sshersh/SuperAudioBoard/KiCADFiles/Mic_Preamp_Sim_Project/averaged_cycle.png

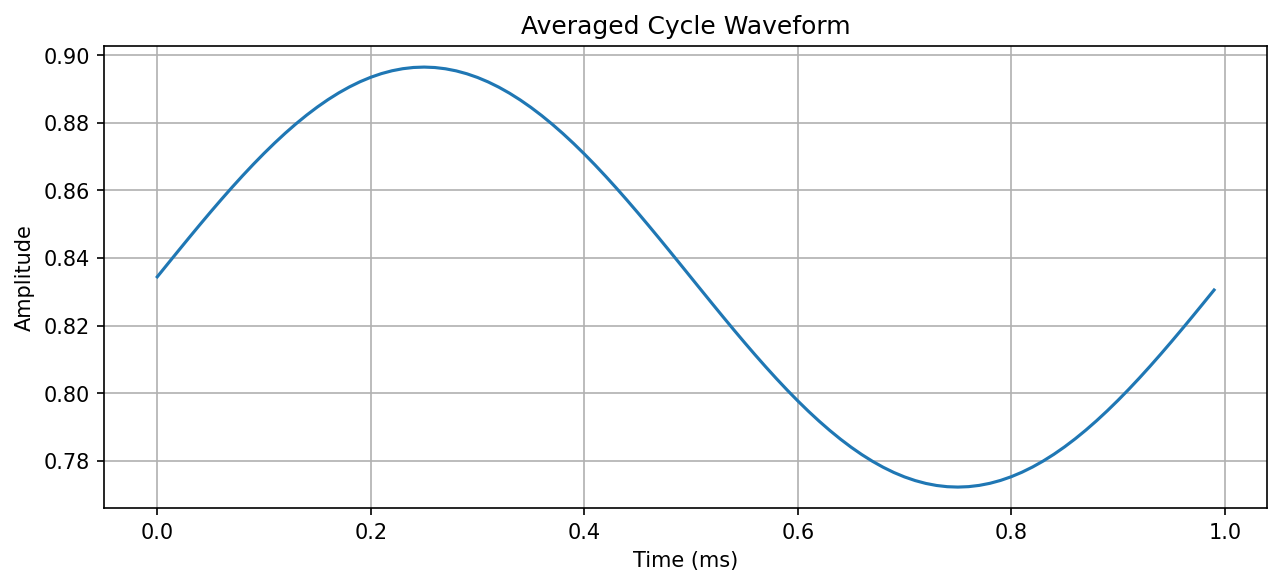
KiCADFiles/Mic_Preamp_Sim_Project/averaged_cycle.png
