sshersh/SuperAudioBoard/KiCADFiles/Mic_Preamp_Sim_Project/bfma_configuration_default_spectrum.png

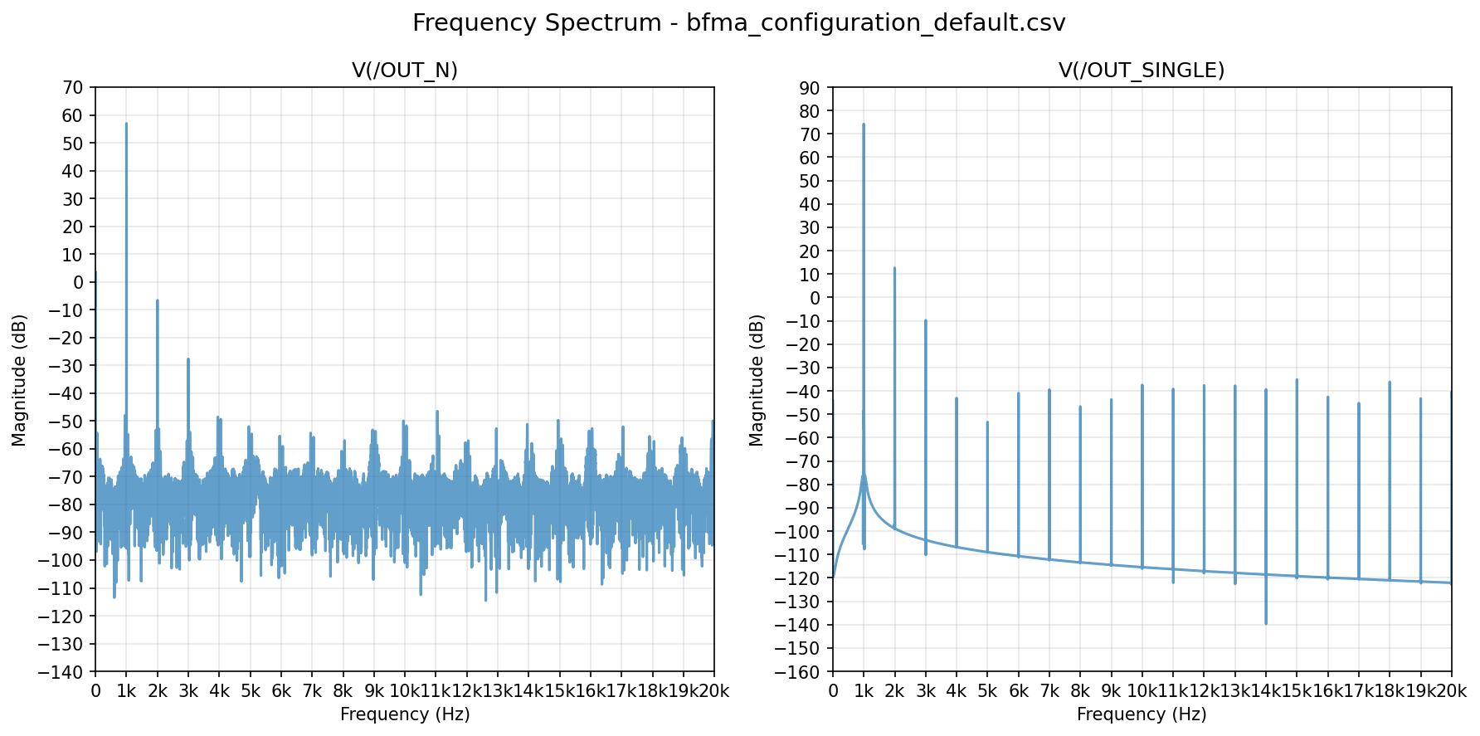
KiCADFiles/Mic_Preamp_Sim_Project/bfma_configuration_default_spectrum.png
