sshersh/SuperAudioBoard/KiCADFiles/Mic_Preamp_Sim_Project/collector_resistors_3k_spectrum.png

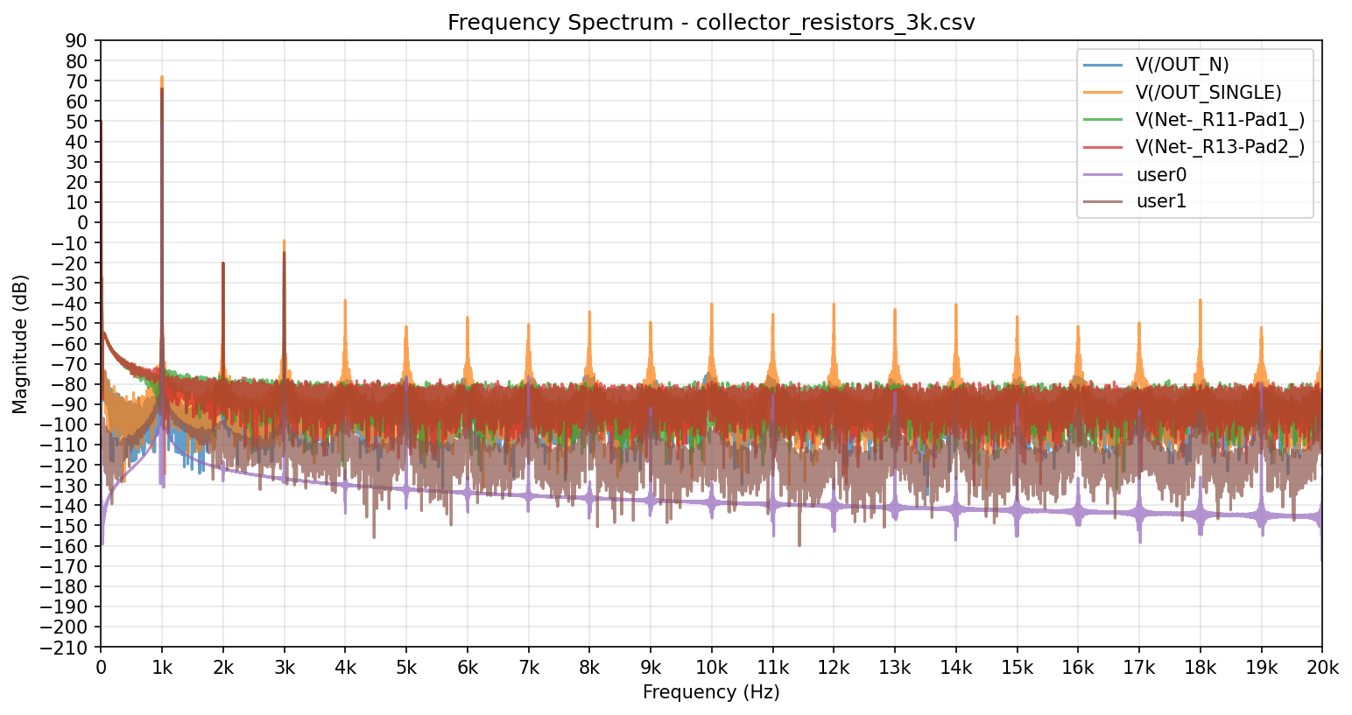
KiCADFiles/Mic_Preamp_Sim_Project/collector_resistors_3k_spectrum.png
