sshersh/SuperAudioBoard/KiCADFiles/Mic_Preamp_Sim_Project/diode_biased_first_stage_spectrum.png

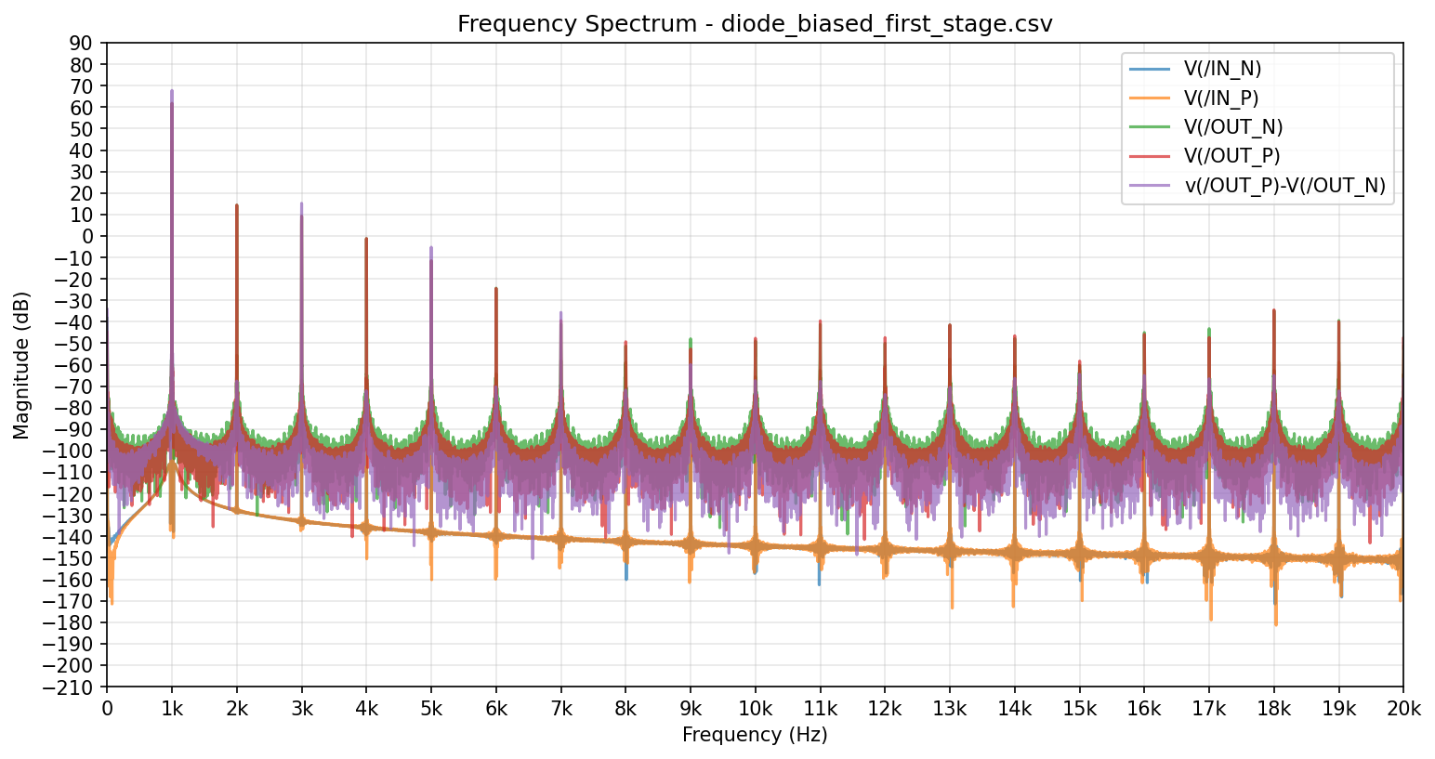
KiCADFiles/Mic_Preamp_Sim_Project/diode_biased_first_stage_spectrum.png
