sshersh/SuperAudioBoard/KiCADFiles/Mic_Preamp_Sim_Project/full_two_stages_10k_fb_res_spectrum.png

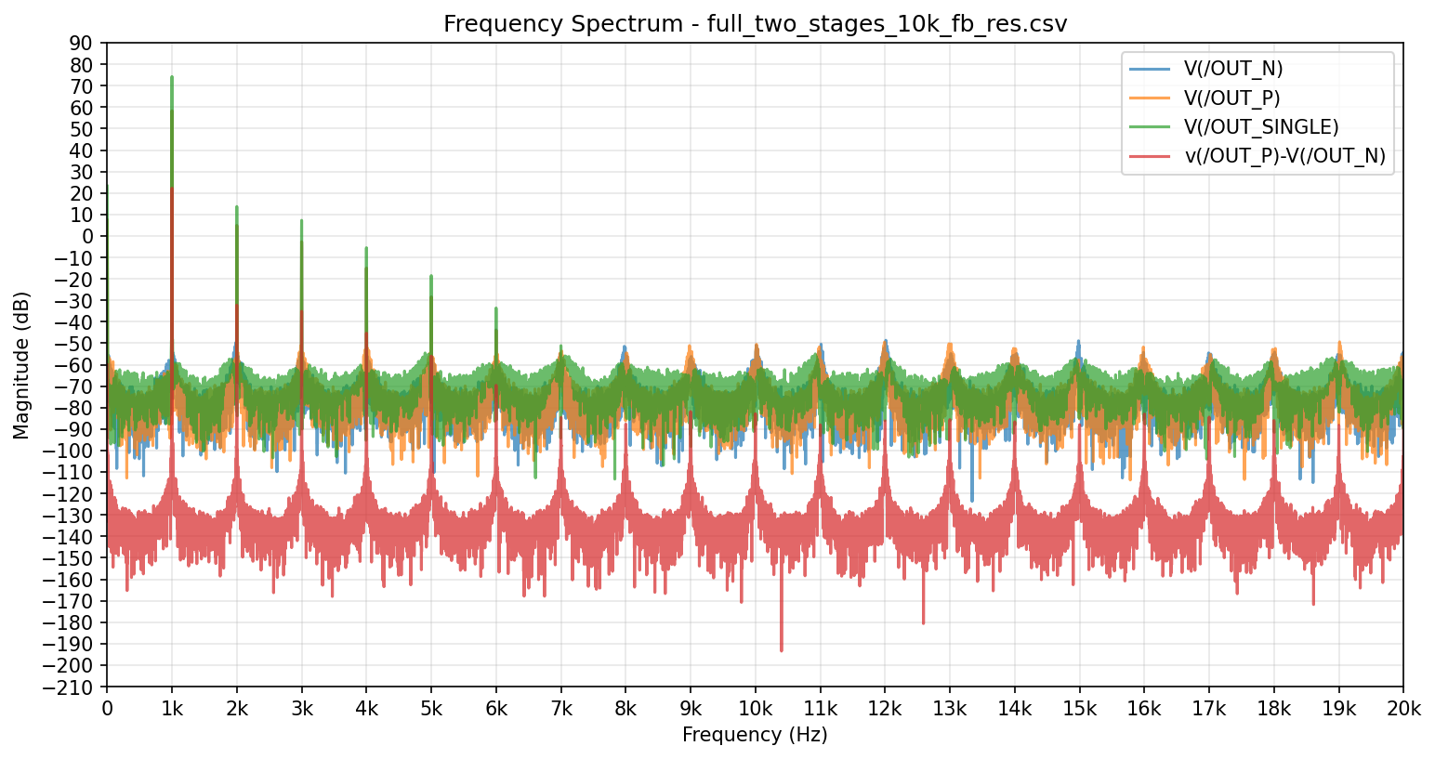
KiCADFiles/Mic_Preamp_Sim_Project/full_two_stages_10k_fb_res_spectrum.png
