sshersh/SuperAudioBoard/KiCADFiles/Mic_Preamp_Sim_Project/highest_gain_setting_22k_fb_spectrum.png

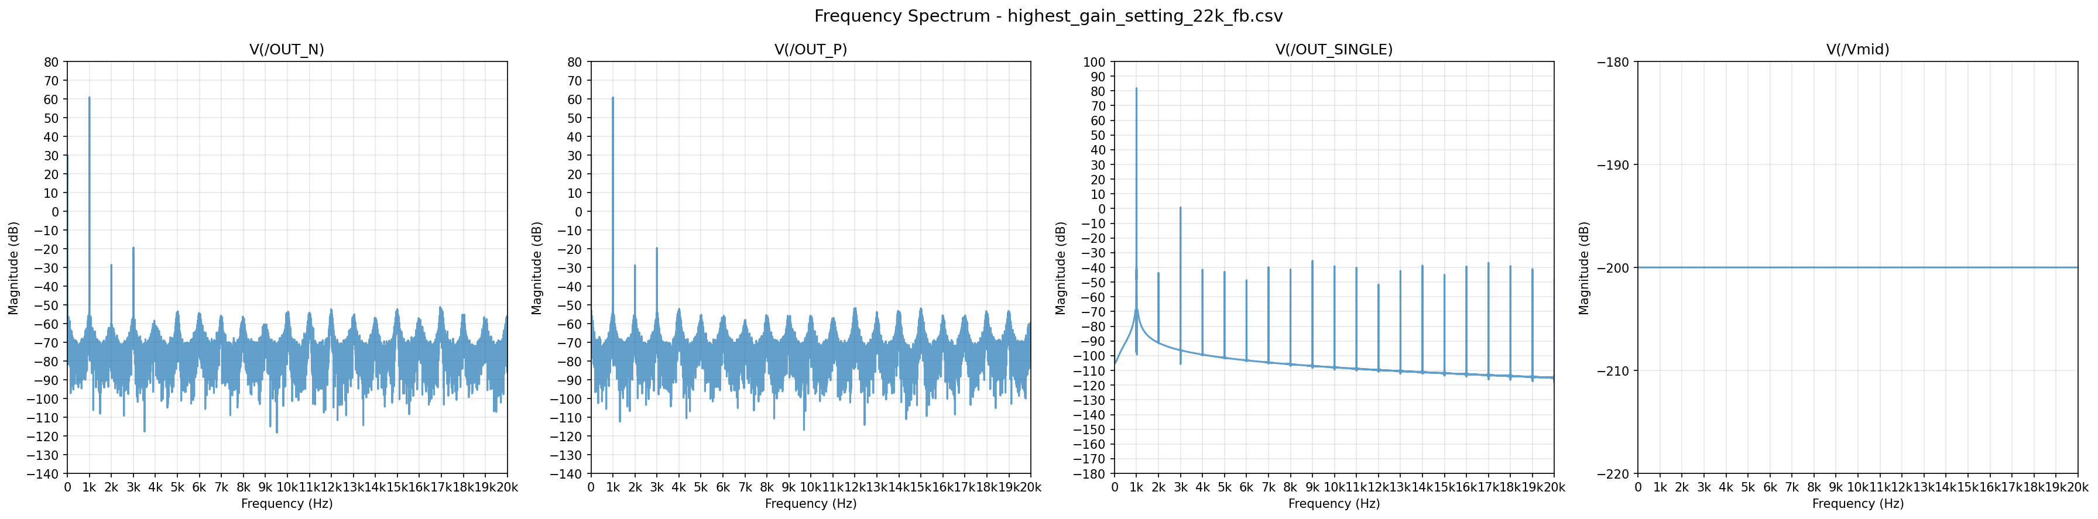
KiCADFiles/Mic_Preamp_Sim_Project/highest_gain_setting_22k_fb_spectrum.png
