sshersh/SuperAudioBoard/KiCADFiles/Mic_Preamp_Sim_Project/instr_amp_full_sim_1s_spectrum.png

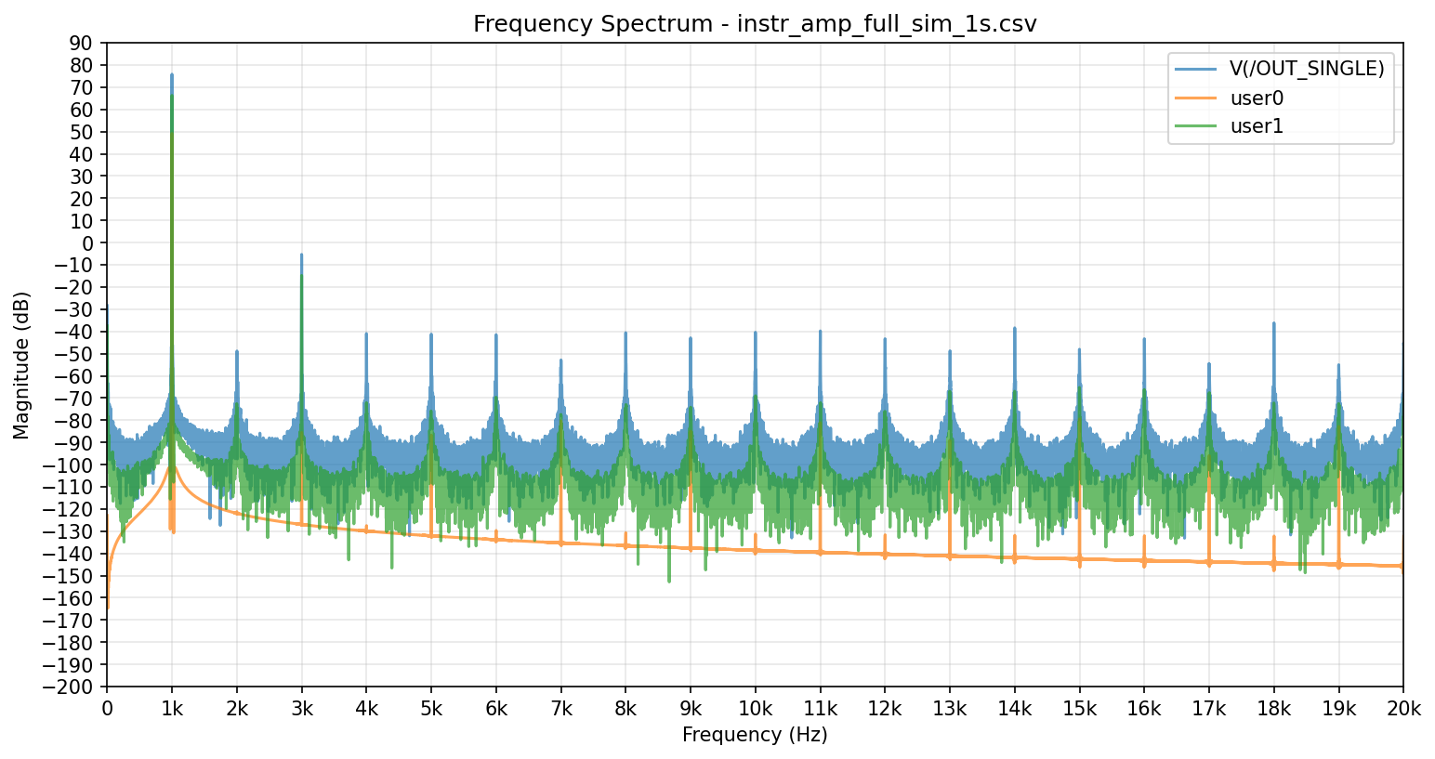
KiCADFiles/Mic_Preamp_Sim_Project/instr_amp_full_sim_1s_spectrum.png
