sshersh/SuperAudioBoard/KiCADFiles/Mic_Preamp_Sim_Project/linearity_capacitor_load_10u_spectrum.png

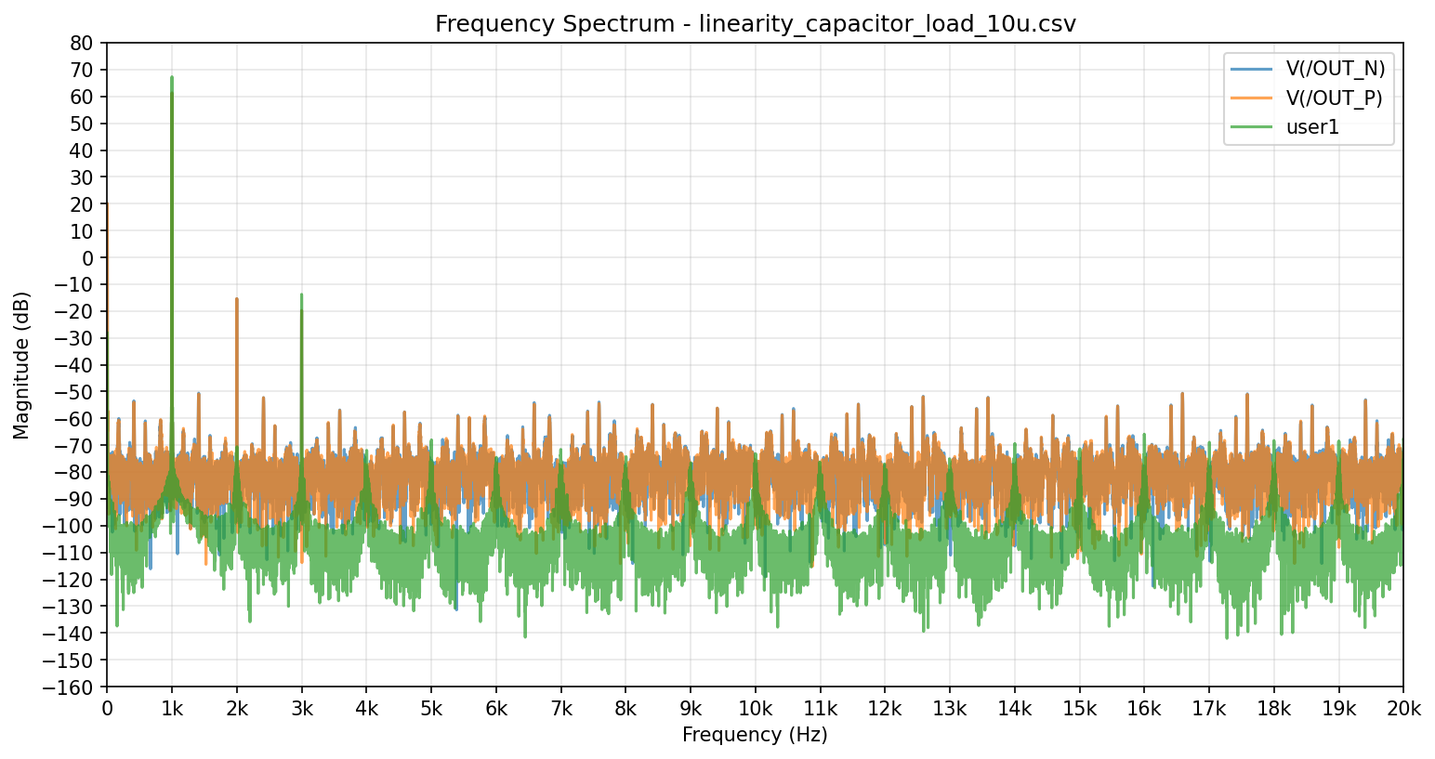
KiCADFiles/Mic_Preamp_Sim_Project/linearity_capacitor_load_10u_spectrum.png
