sshersh/SuperAudioBoard/KiCADFiles/Mic_Preamp_Sim_Project/linearity_loaded_spectrum.png

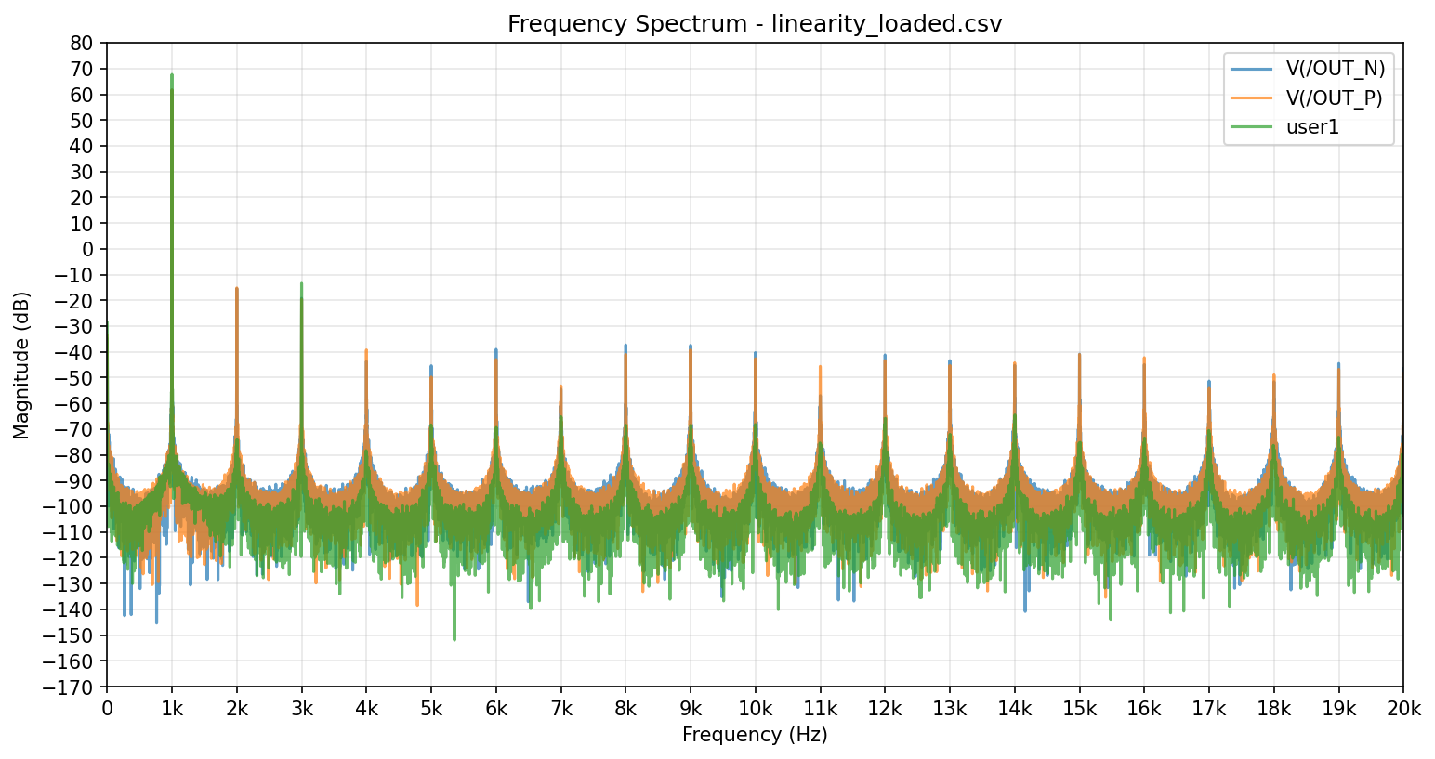
KiCADFiles/Mic_Preamp_Sim_Project/linearity_loaded_spectrum.png
