sshersh/SuperAudioBoard/KiCADFiles/Mic_Preamp_Sim_Project/pmos_instead_spectrum.png

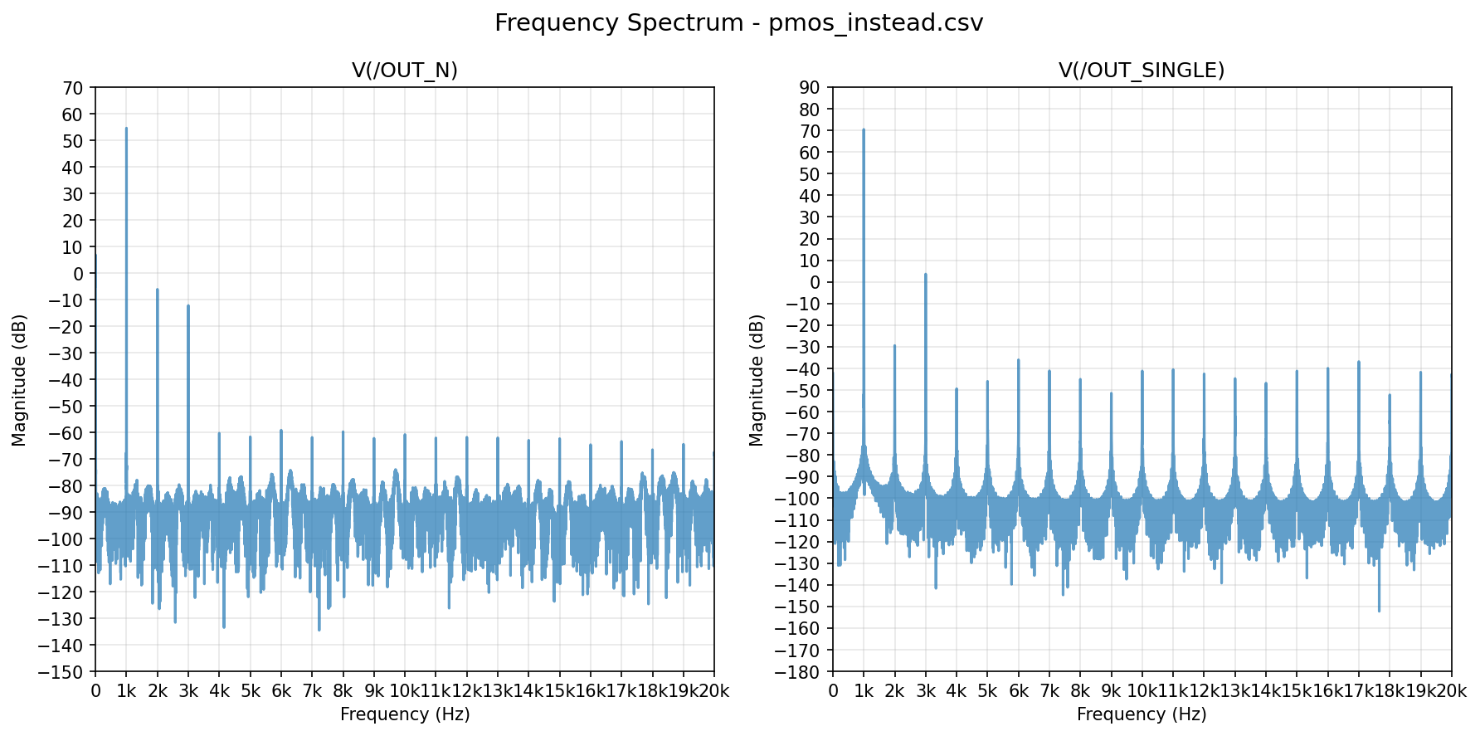
KiCADFiles/Mic_Preamp_Sim_Project/pmos_instead_spectrum.png
