sshersh/SuperAudioBoard/KiCADFiles/Mic_Preamp_Sim_Project/single_op_amp_10k_feedback_10vsupply_spectrum.png

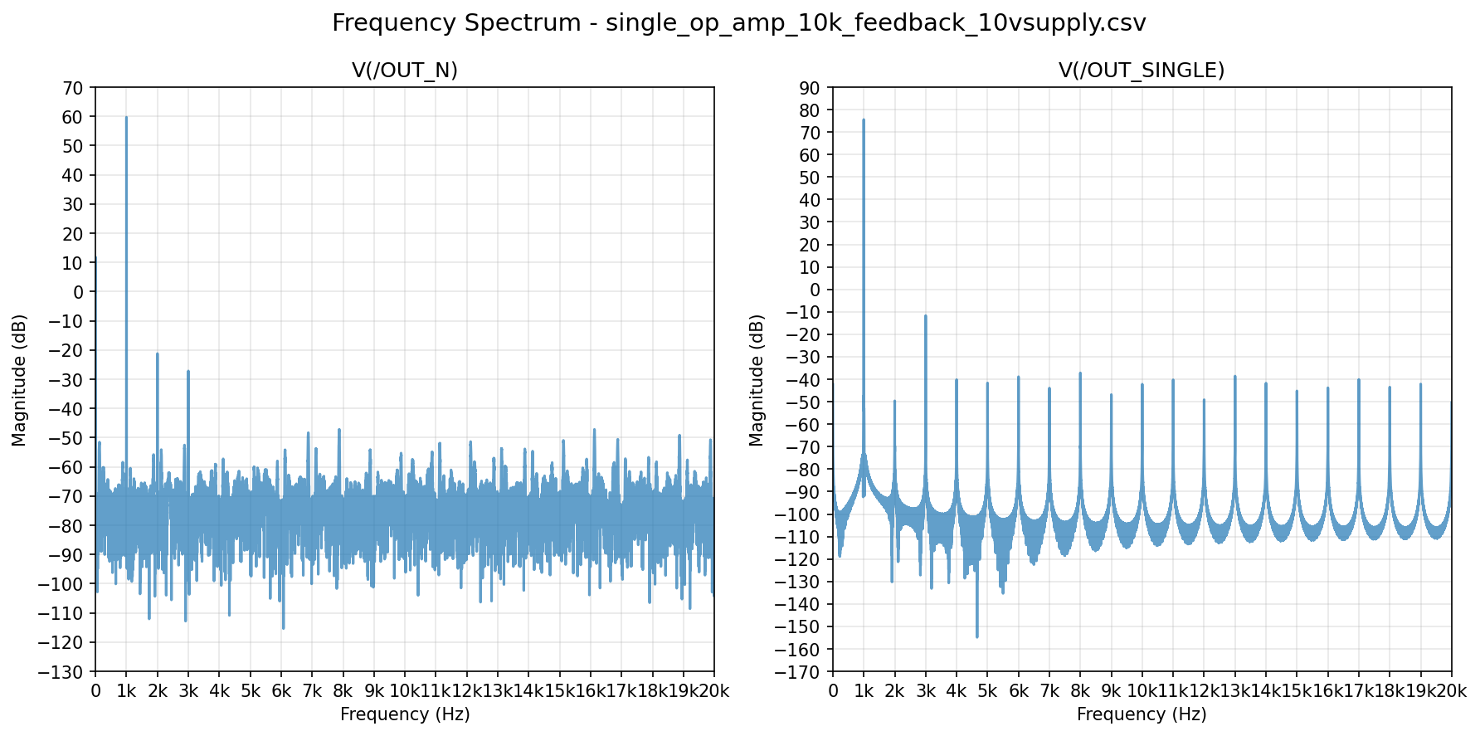
KiCADFiles/Mic_Preamp_Sim_Project/single_op_amp_10k_feedback_10vsupply_spectrum.png
