sshersh/SuperAudioBoard/KiCADFiles/Mic_Preamp_Sim_Project/single_op_amp_22k_feedback_spectrum.png

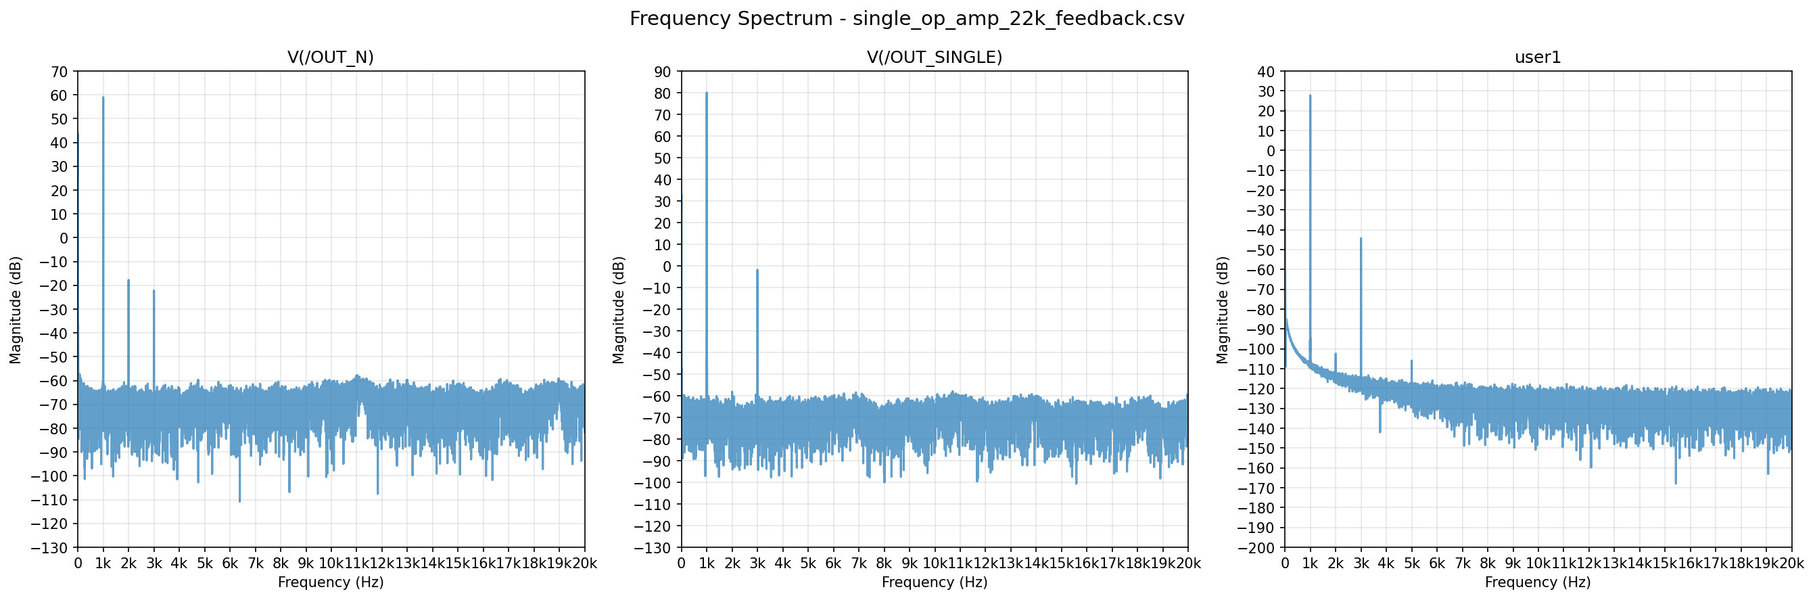
KiCADFiles/Mic_Preamp_Sim_Project/single_op_amp_22k_feedback_spectrum.png
