sshersh/SuperAudioBoard/KiCADFiles/Mic_Preamp_Sim_Project/with_30v_supply_spectrum.png

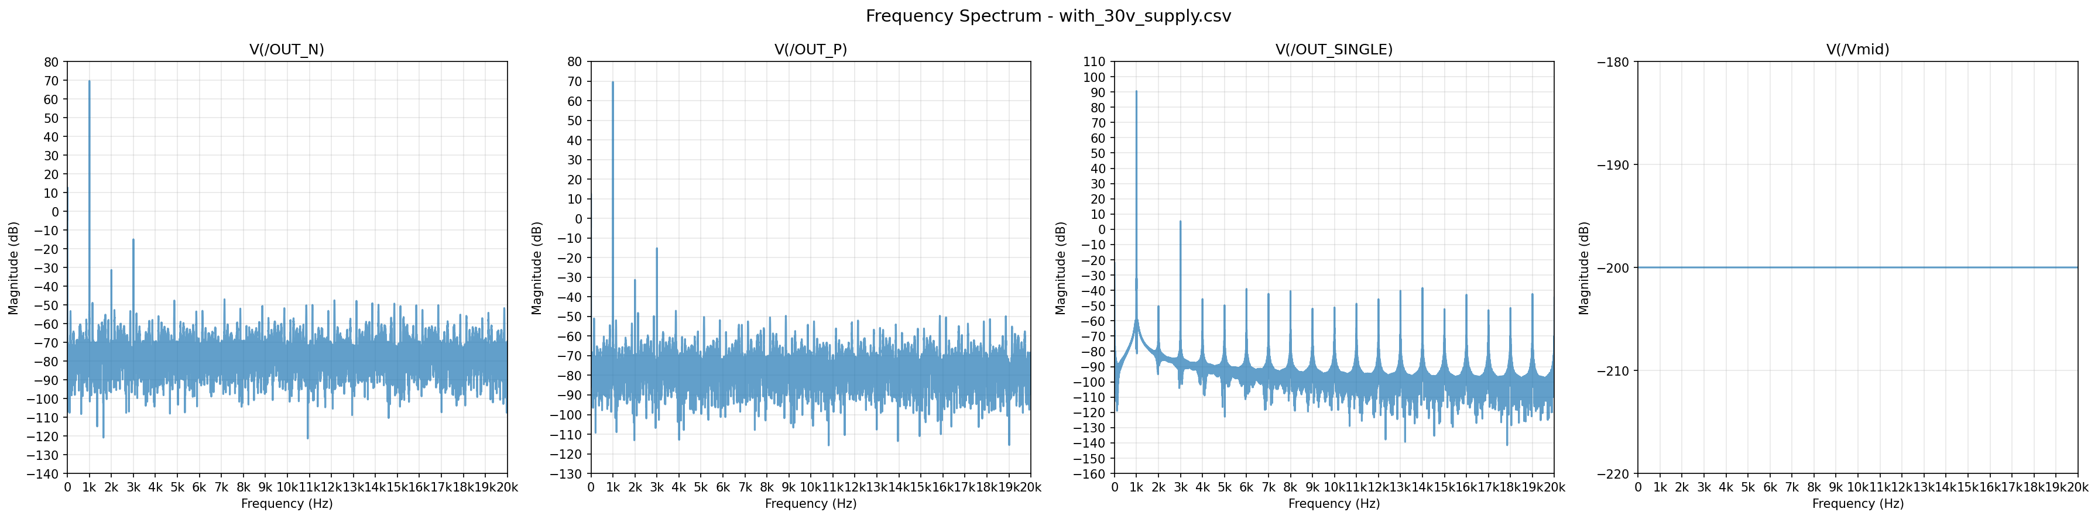
KiCADFiles/Mic_Preamp_Sim_Project/with_30v_supply_spectrum.png
