sshersh/SuperAudioBoard/KiCADFiles/Mic_Preamp_Sim_Project/with_current_source_load_spectrum.png

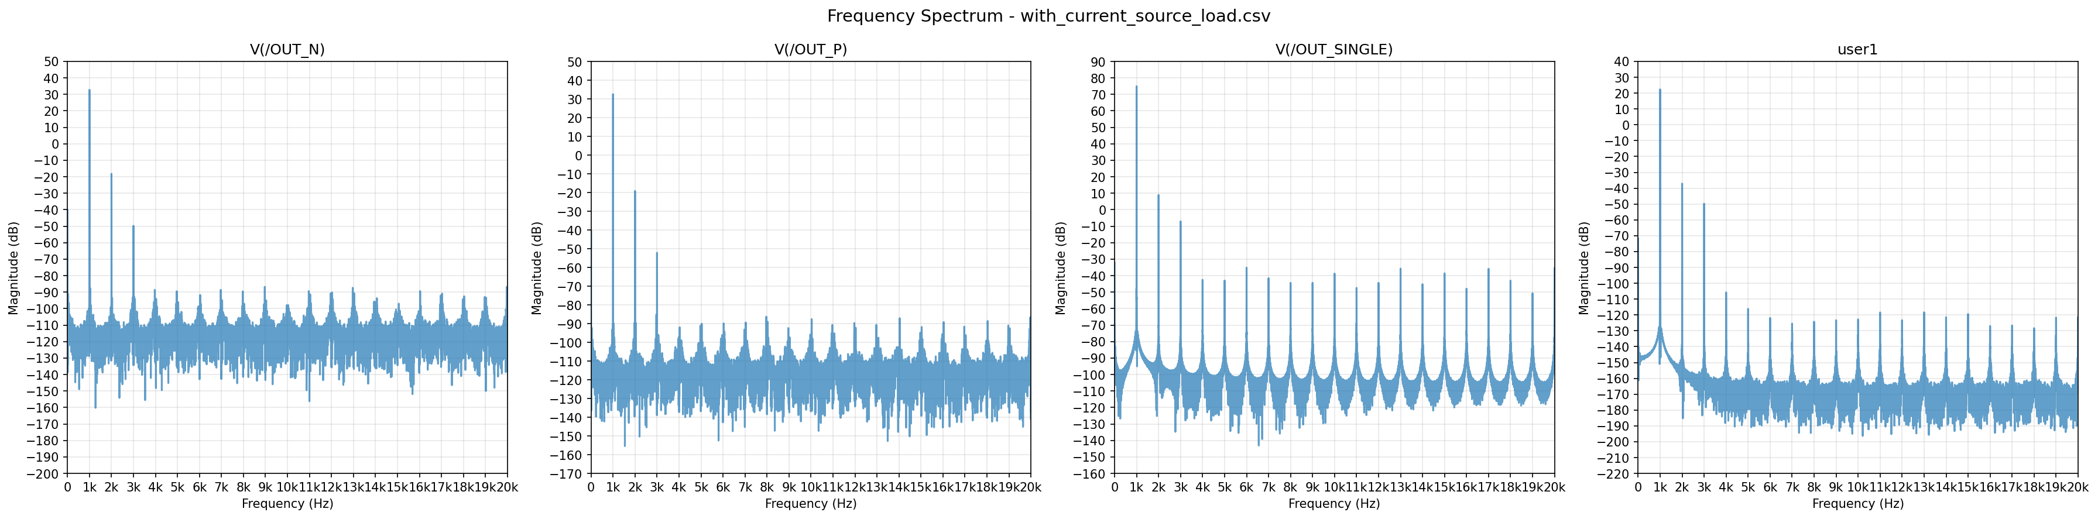
KiCADFiles/Mic_Preamp_Sim_Project/with_current_source_load_spectrum.png
