sshersh/SuperAudioBoard/KiCADFiles/Mic_Preamp_Sim_Project/with_opa1655_spectrum.png

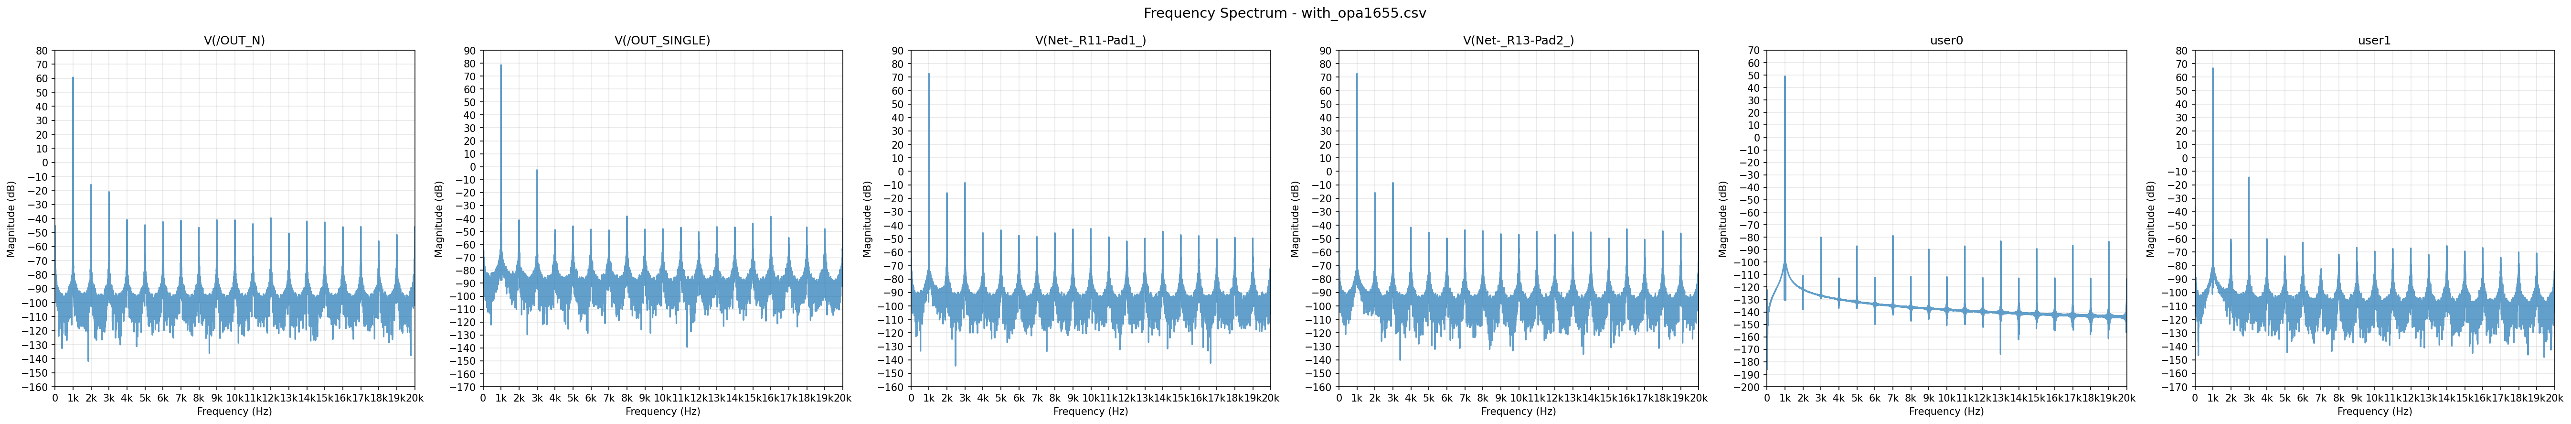
KiCADFiles/Mic_Preamp_Sim_Project/with_opa1655_spectrum.png
