sshersh/SuperAudioBoard/KiCADFiles/Mic_Preamp_Sim_Project/with_protection_diodes_spectrum.png

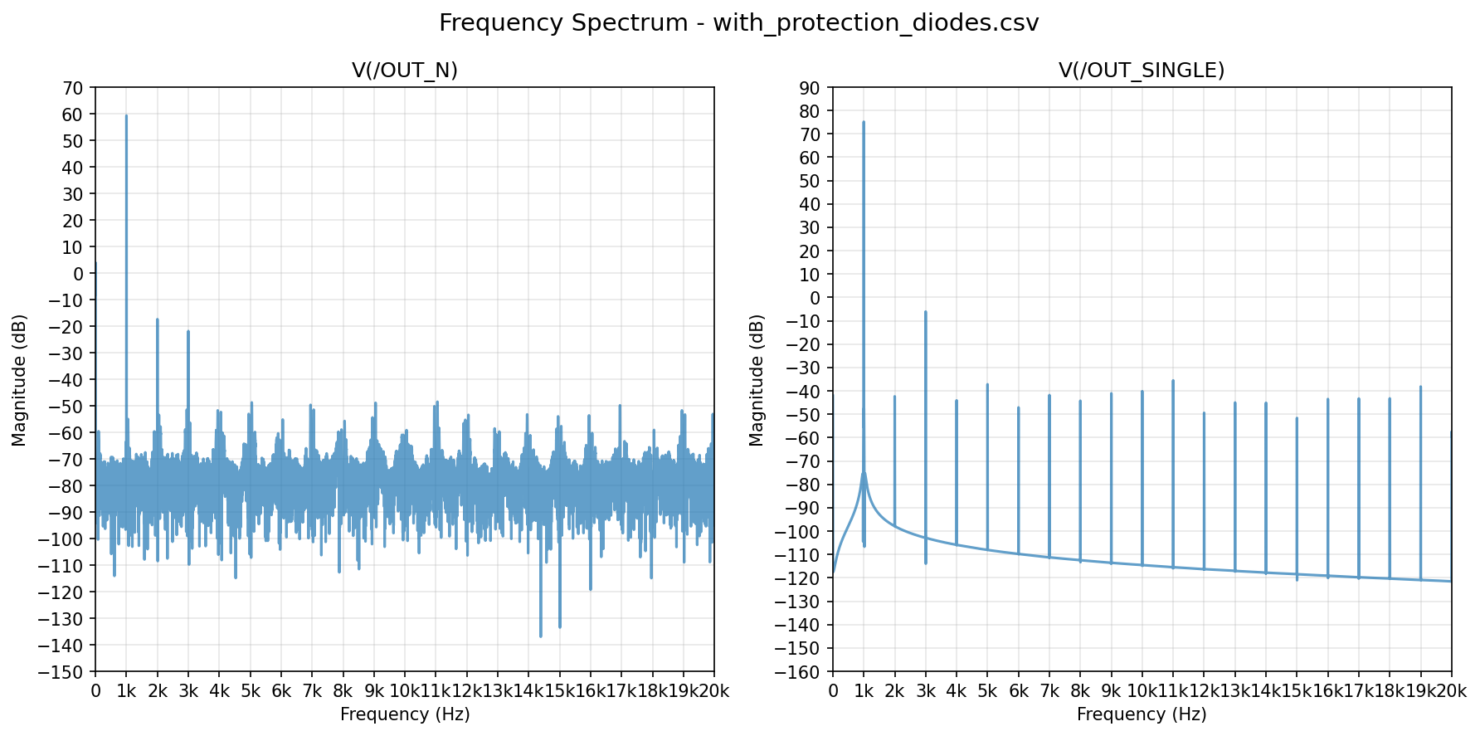
KiCADFiles/Mic_Preamp_Sim_Project/with_protection_diodes_spectrum.png
