sshersh/SuperAudioBoard/KiCADFiles/Mic_Preamp_Sim_Project/without_instr_input_network_spectrum.png

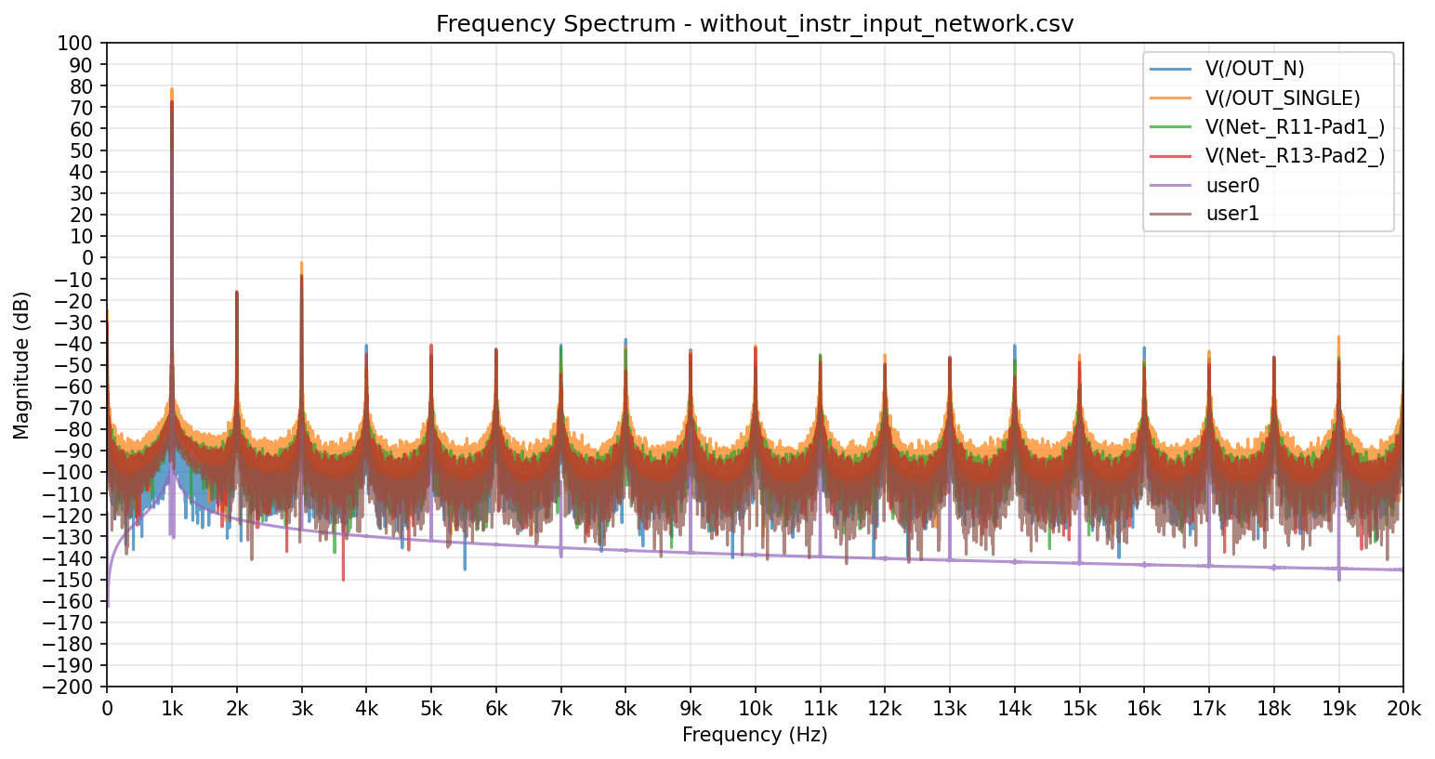
KiCADFiles/Mic_Preamp_Sim_Project/without_instr_input_network_spectrum.png
