sshersh/SuperAudioBoard/KiCADFiles/Mic_Preamp_Sim_Project/test_midpoint_again.csv

time | user0 | user1
0.100001 | 0.000149784 | -0.00112278
0.100011 | 0.00140723 | -0.00928184
0.100021 | 0.00265913 | -0.017404
0.100031 | 0.00390053 | -0.025457
0.100041 | 0.00512654 | -0.0334089
0.100051 | 0.00633232 | -0.0412279
0.100061 | 0.0075131 | -0.0488832
0.100071 | 0.00866424 | -0.0563443
0.100081 | 0.00978118 | -0.0635817
0.100091 | 0.0108595 | -0.0705669
0.100101 | 0.011895 | -0.0772723
0.100111 | 0.0128835 | -0.0836714
0.100121 | 0.0138212 | -0.0897391
0.100131 | 0.0147044 | -0.0954517
0.100141 | 0.0155295 | -0.100787
0.100151 | 0.0162933 | -0.105724
0.100161 | 0.0169928 | -0.110243
0.100171 | 0.0176253 | -0.114327
0.100181 | 0.0181882 | -0.11796
0.100191 | 0.0186793 | -0.121128
0.100201 | 0.0190967 | -0.123818
0.100211 | 0.0194388 | -0.126021
0.100221 | 0.0197041 | -0.127728
0.100231 | 0.0198916 | -0.128931
0.100241 | 0.0200007 | -0.129628
0.100251 | 0.0200308 | -0.129814
0.100261 | 0.0199819 | -0.129489
0.100271 | 0.0198541 | -0.128655
0.100281 | 0.0196479 | -0.127315
0.100291 | 0.0193643 | -0.125473
0.100301 | 0.0190041 | -0.123137
0.100311 | 0.018569 | -0.120316
0.100321 | 0.0180606 | -0.117021
0.100331 | 0.017481 | -0.113264
0.100341 | 0.0168323 | -0.10906
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
