sshersh/SuperAudioBoard/KiCADFiles/Mic_Preamp_Sim_Project/test_1v_base_spectrum.png

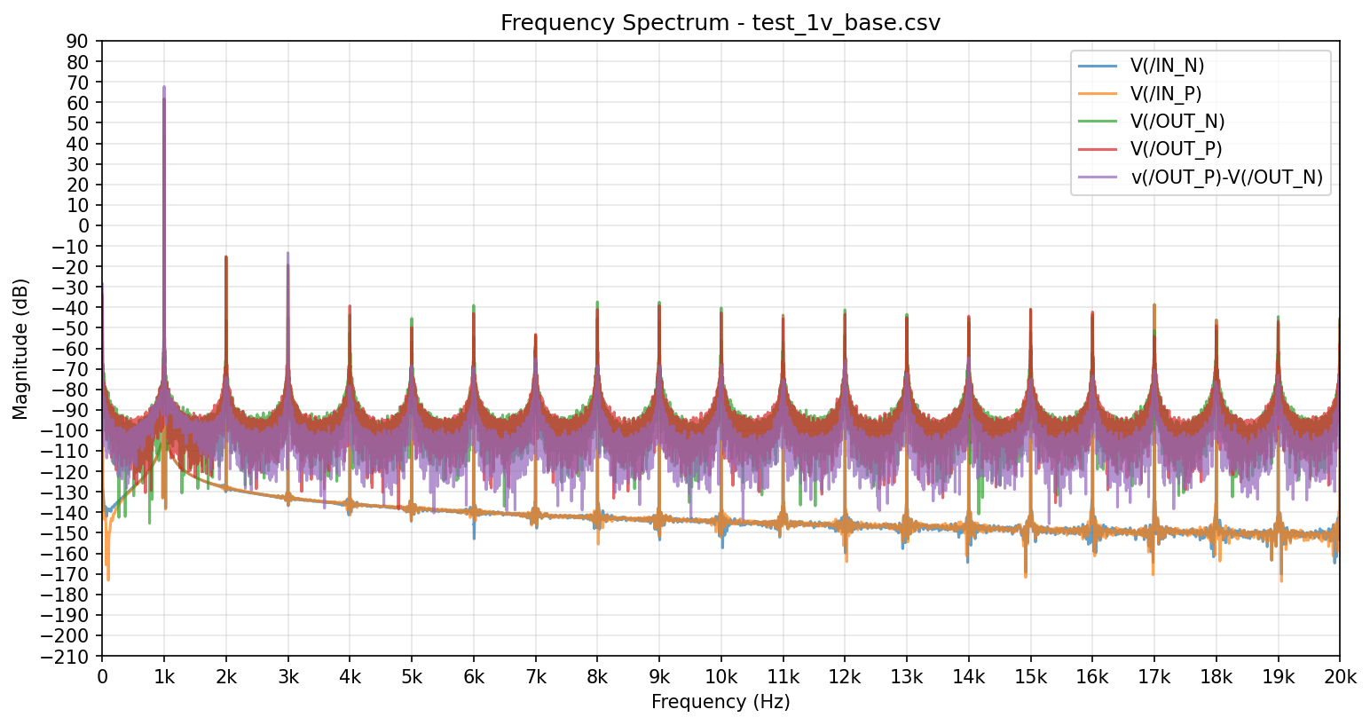
KiCADFiles/Mic_Preamp_Sim_Project/test_1v_base_spectrum.png
