sshersh/SuperAudioBoard/KiCADFiles/Board/SuperAudioBoard.kicad_pcb

## KiCad design KiCADFiles/Board/SuperAudioBoard.kicad_pcb (2026-03-12)

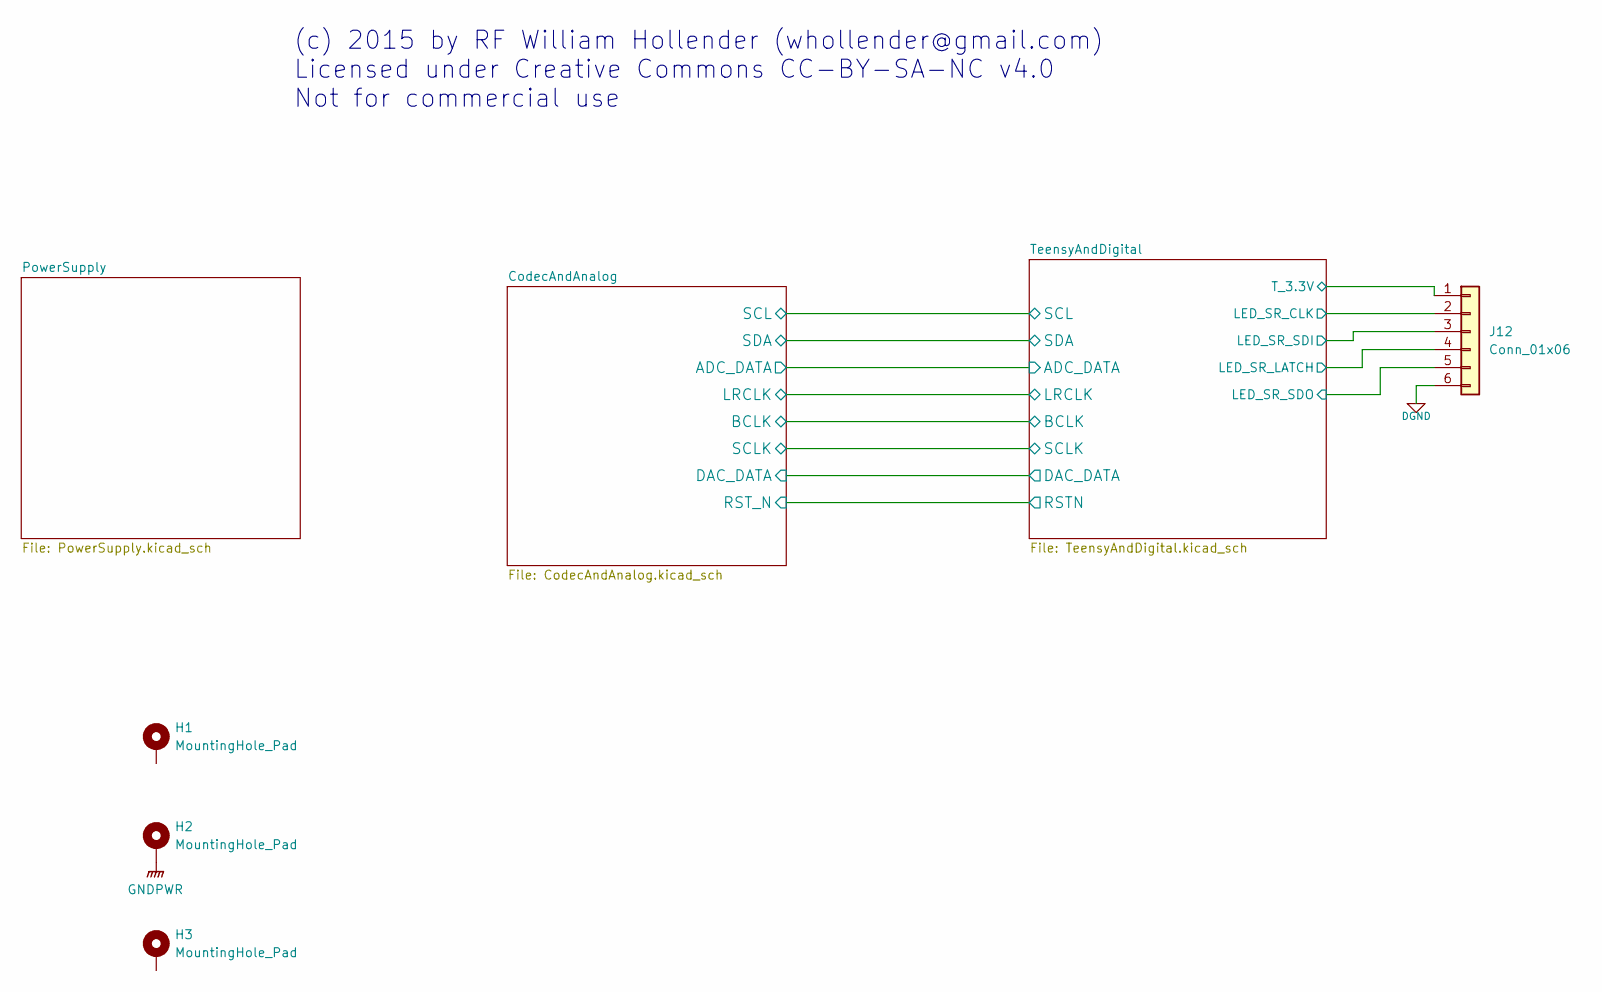
[picture p24: schematic SuperAudioBoard.kicad_sch, 24 bit audio board for Teensy 3.x]

Parts:
H1, H2, H3: MountingHole_Pad; MountingHole_3.2mm_M3_DIN965_Pad
J12: Conn_01x06; JST_EH_B6B-EH-A_1x06_P2.50mm_Vertical

Connections:
/TeensyAndDigital/LED_SR_CLK: J12.2; also elsewhere on the board
/TeensyAndDigital/LED_SR_LATCH: J12.4; also elsewhere on the board
/TeensyAndDigital/LED_SR_SDI: J12.3; also elsewhere on the board
/TeensyAndDigital/LED_SR_SDO: J12.5; also elsewhere on the board
/TeensyAndDigital/T_3.3V: J12.1; also elsewhere on the board
DGND: J12.6; also elsewhere on the board
GNDPWR: H2.1; also elsewhere on the board

Notes on the sheet:
(c) 2015 by RF William Hollender (whollender@gmail.com) Licensed under Creative Commons CC-BY-SA-NC v4.0 Not for commercial use

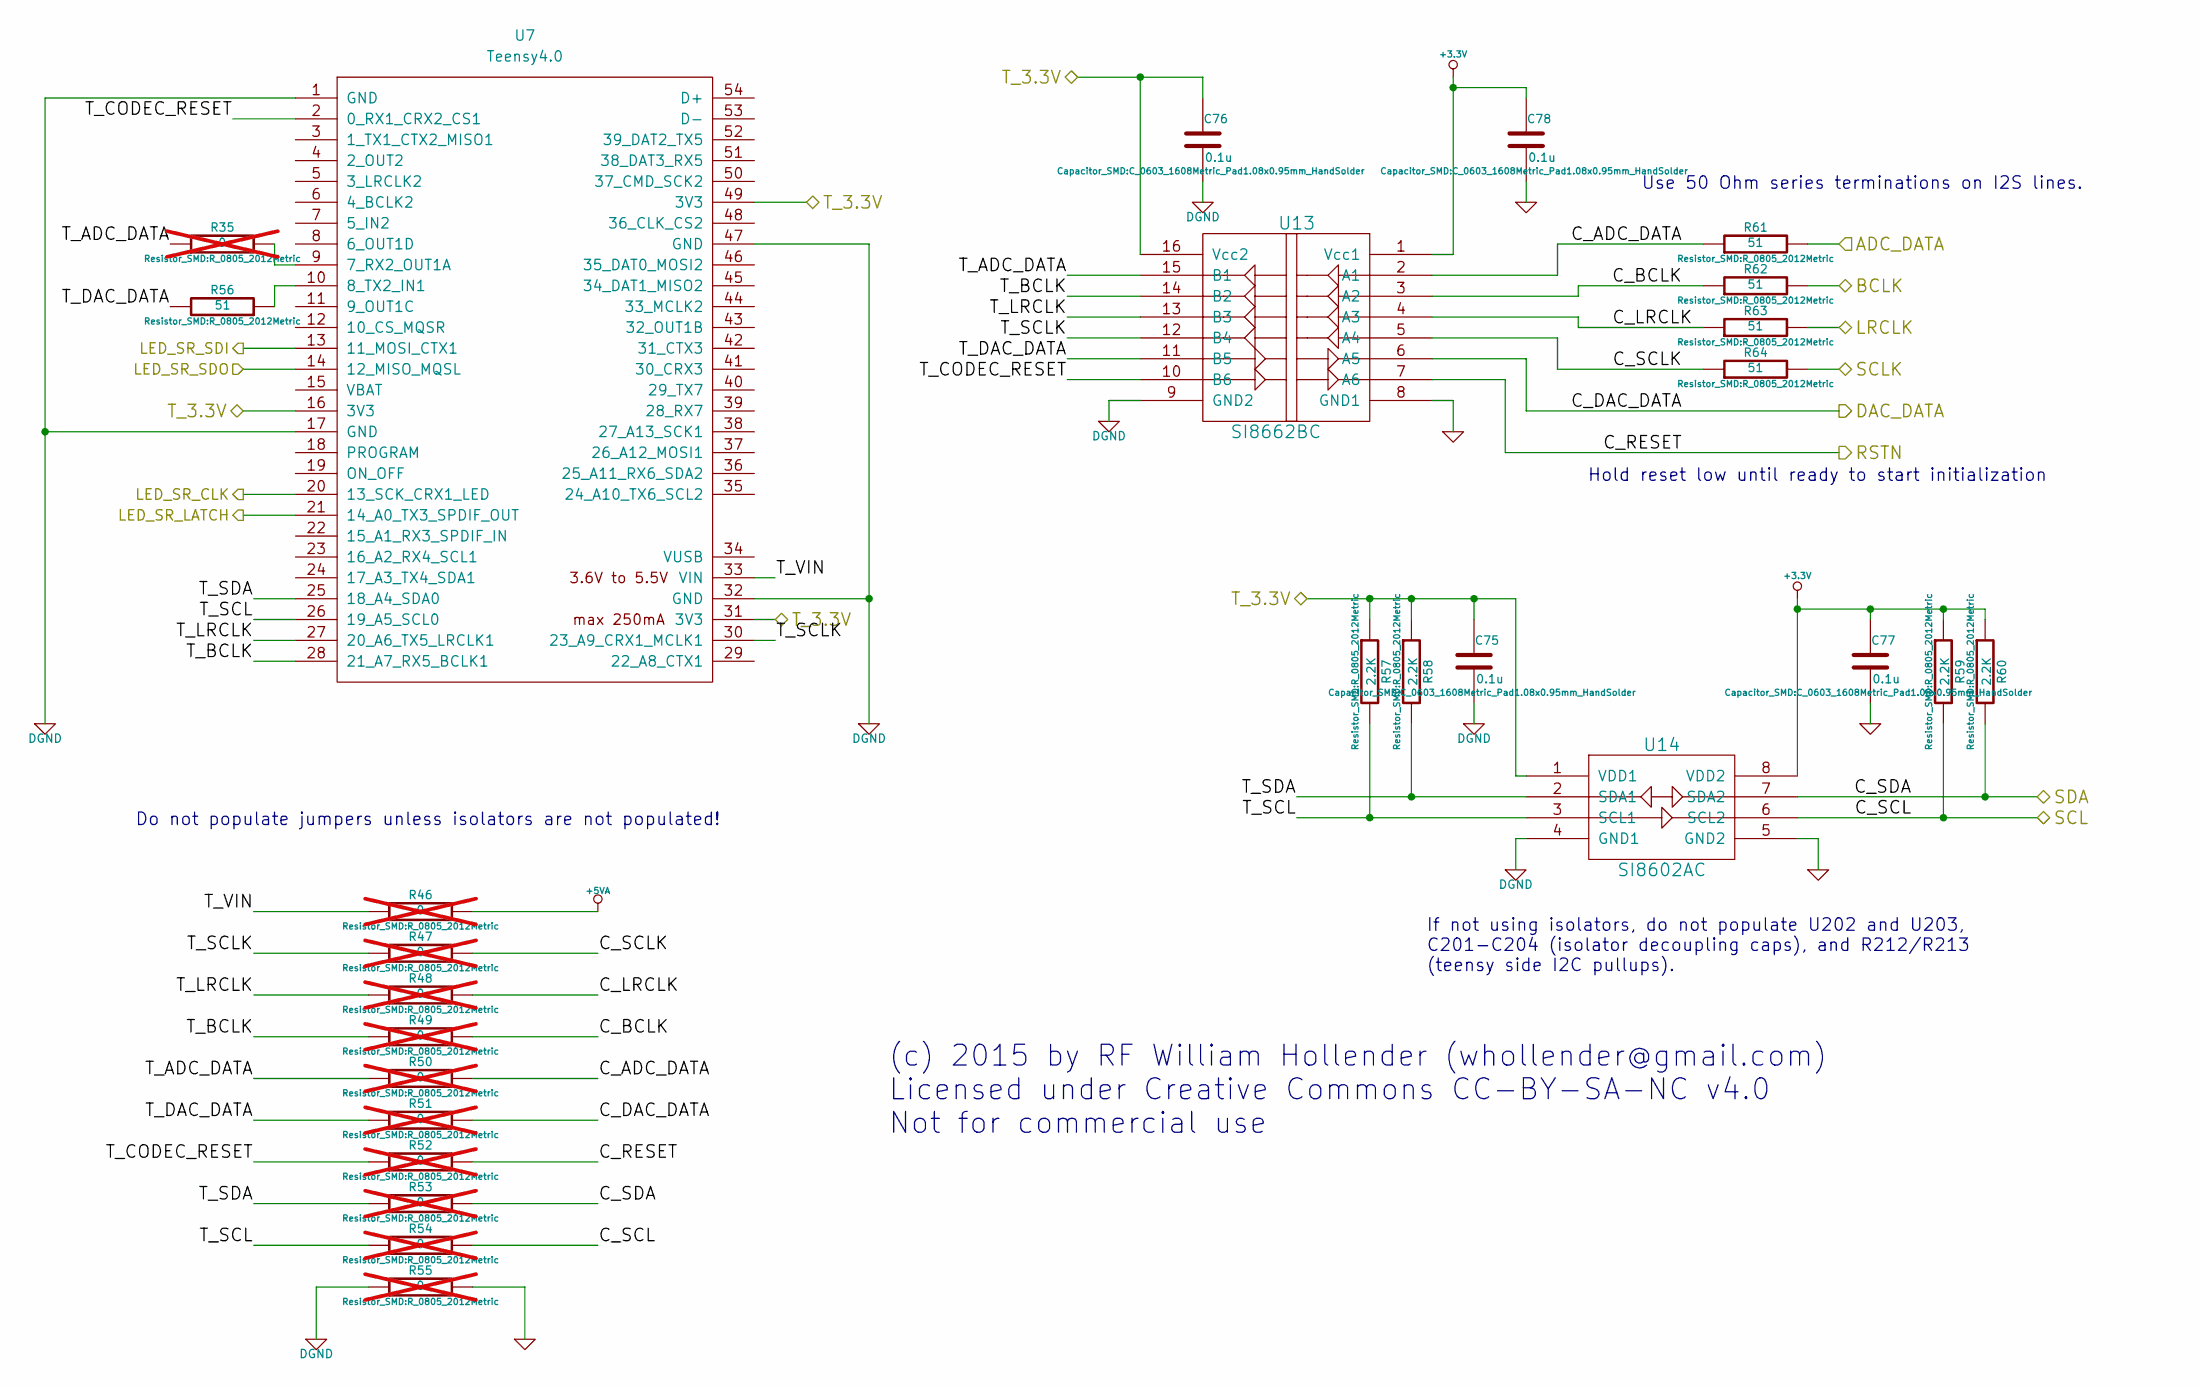
[picture p25: schematic TeensyAndDigital.kicad_sch, 24 bit audio board for Teensy 3.x]

Parts:
C75, C76, C77, C78: 0.1u; C_0603_1608Metric_Pad1.08x0.95mm_HandSolder; MFG1 PN GRM188R71E104KA01
R35, R46, R47, R48, R49, R50, R51, R52, R53, R54, R55: 0; R_0805_2012Metric; MFG1 PN RC0805JR-070RL; not fitted
R56, R61, R62, R63, R64: 51; R_0805_2012Metric; MFG1 PN CRCW080551R0JNEA
R57, R58, R59, R60: 2.2K; R_0805_2012Metric; MFG1 PN RC0805JR-072K2L
U7: Teensy4.0; Teensy40; MPN Teensy4.0
U13: SI8662BC; SOIC-16W_7.5x10.3mm_P1.27mm; MFG1 PN SI8662BC
U14: SI8602AC; SOIC-8_3.9x4.9mm_P1.27mm; MFG1 PN SI8602AC

Connections:
+3.3V: C77.1, C78.1, R59.1, R60.1, U13.1 (Vcc1), U14.8 (VDD2); also elsewhere on the board
+5VA: R46.2; also elsewhere on the board
/CodecAndAnalog/ADC_DATA: R61.2; also elsewhere on the board
/CodecAndAnalog/BCLK: R62.2; also elsewhere on the board
/CodecAndAnalog/LRCLK: R63.2; also elsewhere on the board
/CodecAndAnalog/SCLK: R64.2; also elsewhere on the board
/TeensyAndDigital/C_ADC_DATA: R50.2, R61.1, U13.2 (A1)
/TeensyAndDigital/C_BCLK: R49.2, R62.1, U13.3 (A2)
/TeensyAndDigital/C_DAC_DATA: R51.2, U13.6 (A5); also elsewhere on the board
/TeensyAndDigital/C_LRCLK: R48.2, R63.1, U13.4 (A3)
/TeensyAndDigital/C_RESET: R52.2, U13.7 (A6); also elsewhere on the board
/TeensyAndDigital/C_SCL: R54.2, R59.2, U14.6 (SCL2); also elsewhere on the board
/TeensyAndDigital/C_SCLK: R47.2, R64.1, U13.5 (A4)
/TeensyAndDigital/C_SDA: R53.2, R60.2, U14.7 (SDA2); also elsewhere on the board
/TeensyAndDigital/LED_SR_CLK: U7.20 (13_SCK_CRX1_LED); also elsewhere on the board
/TeensyAndDigital/LED_SR_LATCH: U7.21 (14_A0_TX3_SPDIF_OUT); also elsewhere on the board
/TeensyAndDigital/LED_SR_SDI: U7.13 (11_MOSI_CTX1); also elsewhere on the board
/TeensyAndDigital/LED_SR_SDO: U7.14 (12_MISO_MQSL); also elsewhere on the board
/TeensyAndDigital/T_3.3V: C75.1, C76.1, R57.1, R58.1, U7.16 (3V3), U7.31 (3V3), U7.49 (3V3), U13.16 (Vcc2), U14.1 (VDD1); also elsewhere on the board
/TeensyAndDigital/T_ADC_DATA: R35.1, R50.1, U13.15 (B1)
/TeensyAndDigital/T_BCLK: R49.1, U7.28 (21_A7_RX5_BCLK1), U13.14 (B2)
/TeensyAndDigital/T_CODEC_RESET: R52.1, U7.2 (0_RX1_CRX2_CS1), U13.10 (B6)
/TeensyAndDigital/T_DAC_DATA: R51.1, R56.2, U13.11 (B5)
/TeensyAndDigital/T_LRCLK: R48.1, U7.27 (20_A6_TX5_LRCLK1), U13.13 (B3)
/TeensyAndDigital/T_SCL: R54.1, R57.2, U7.26 (19_A5_SCL0), U14.3 (SCL1)
/TeensyAndDigital/T_SCLK: R47.1, U7.30 (23_A9_CRX1_MCLK1), U13.12 (B4)
/TeensyAndDigital/T_SDA: R53.1, R58.2, U7.25 (18_A4_SDA0), U14.2 (SDA1)
/TeensyAndDigital/T_VIN: R46.1, U7.33 (VIN)
DGND: C75.2, C76.2, R55.1, U7.1 (GND), U7.17 (GND), U7.32 (GND), U7.47 (GND), U13.9 (GND2), U14.4 (GND1); also elsewhere on the board
GND: C77.2, C78.2, R55.2, U13.8 (GND1), U14.5 (GND2); also elsewhere on the board
unnamed: R35.2, U7.9 (7_RX2_OUT1A)
unnamed: R56.1, U7.10 (8_TX2_IN1)

Notes on the sheet:
Do not populate jumpers unless isolators are not populated!
(c) 2015 by RF William Hollender (whollender@gmail.com) Licensed under Creative Commons CC-BY-SA-NC v4.0 Not for commercial use
If not using isolators, do not populate U202 and U203, C201-C204 (isolator decoupling caps), and R212/R213 (teensy side I2C pullups).
Use 50 Ohm series terminations on I2S lines.
Hold reset low until ready to start initialization

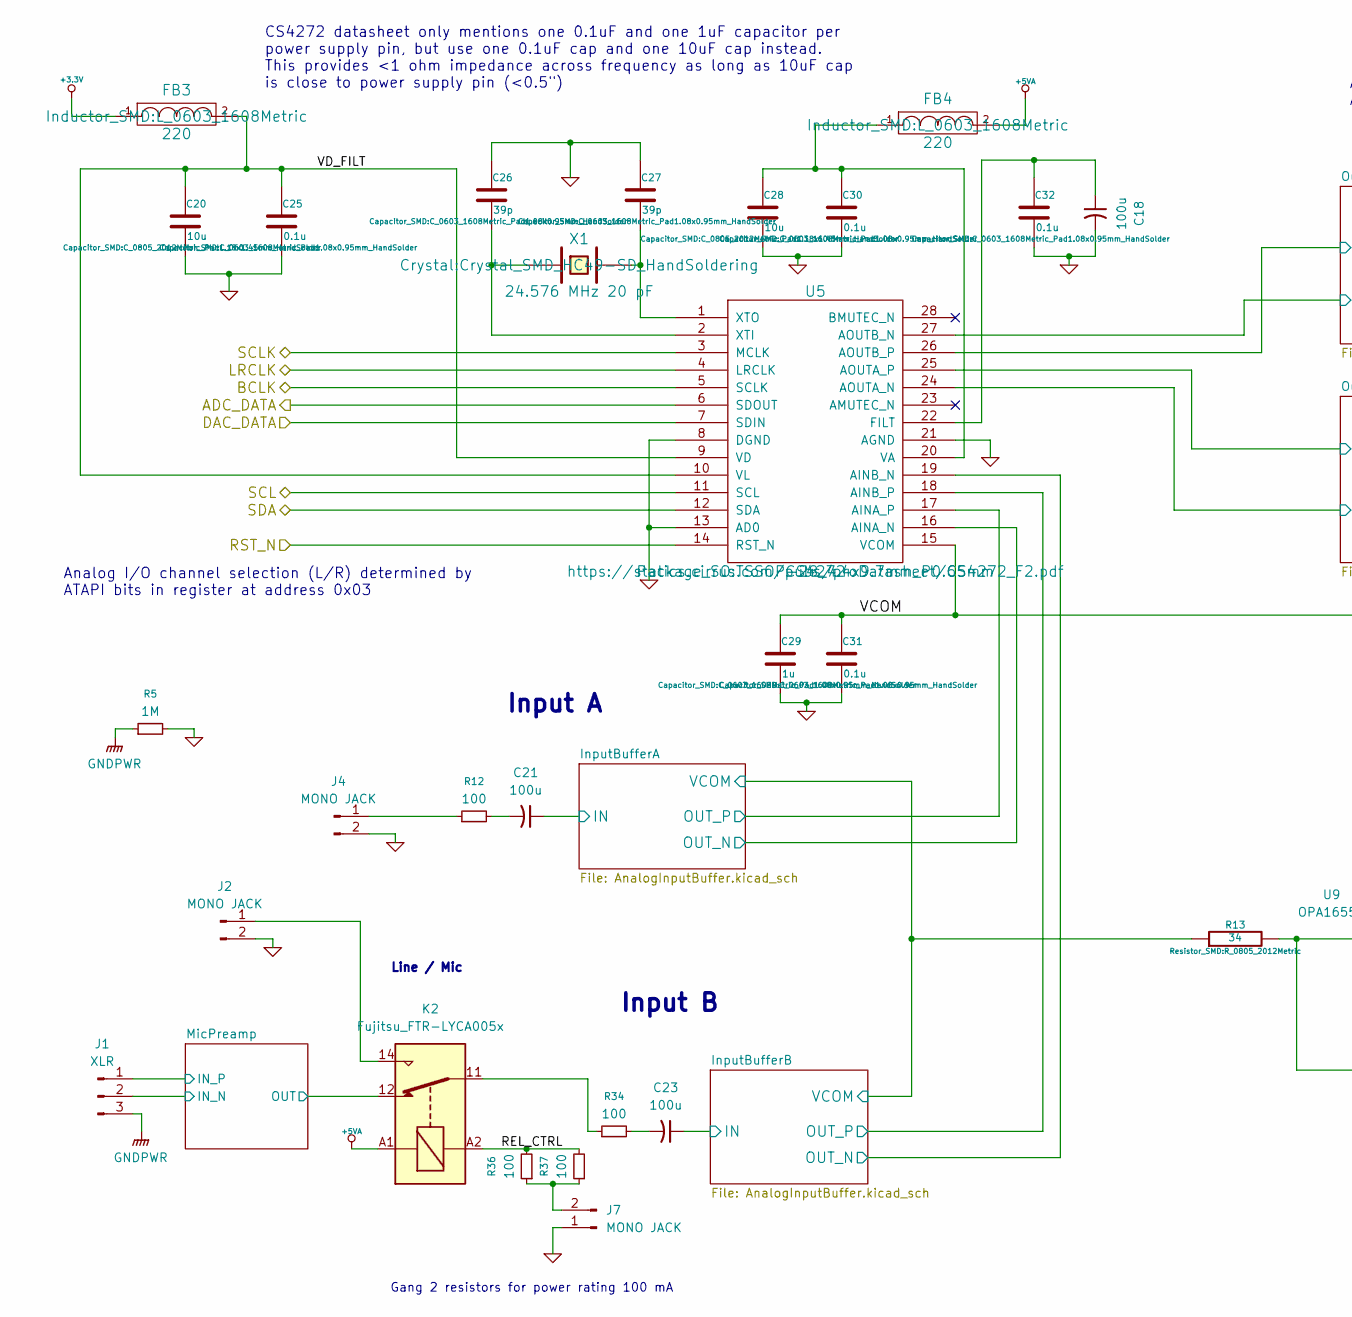
[picture p26: schematic CodecAndAnalog.kicad_sch, 24 bit audio board for Teensy 3.x, part in row 1, column 1]

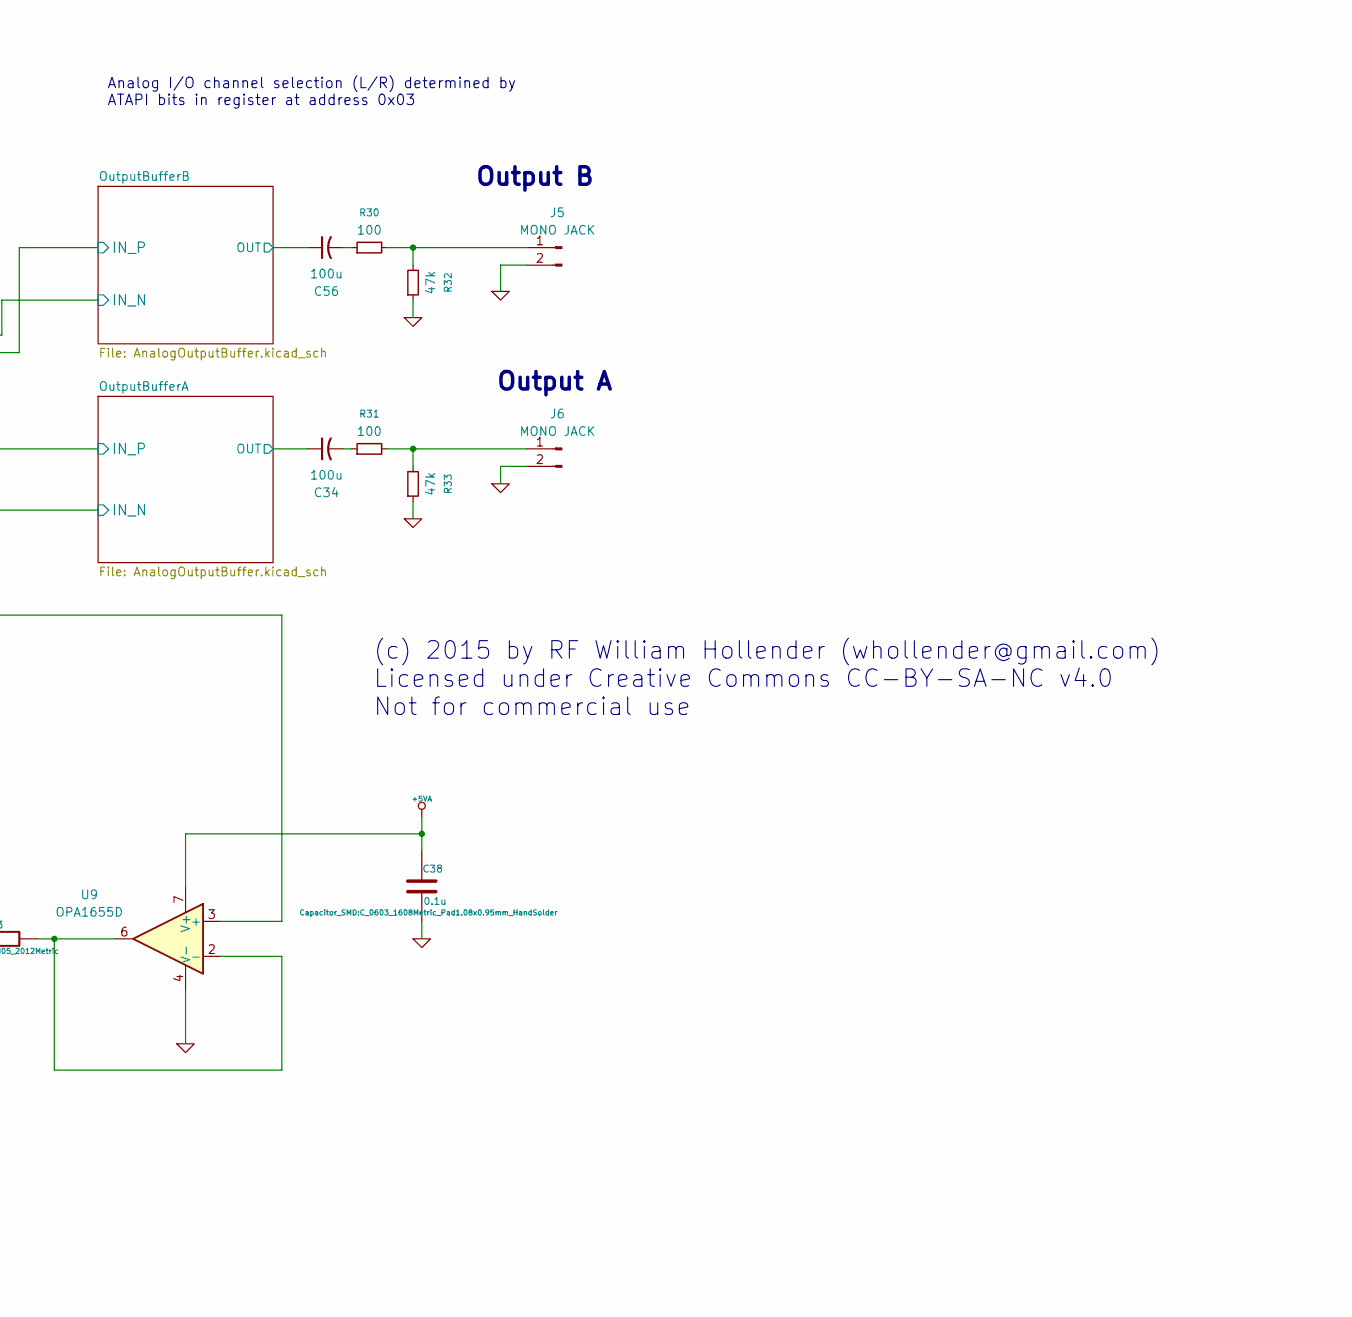
[picture p27: schematic CodecAndAnalog.kicad_sch, 24 bit audio board for Teensy 3.x, part in row 1, column 2]

Parts:
C18, C21, C23, C34, C56: 100u; CP_Radial_D5.0mm_P2.00mm; MPN 25PX100MEFC5X11
C20, C28: 10u; C_0805_2012Metric_Pad1.18x1.45mm_HandSolder; Voltage 25V; MFG1 PN GRM32DR71E106KA12
C25, C30, C31, C32, C38: 0.1u; C_0603_1608Metric_Pad1.08x0.95mm_HandSolder; MFG1 PN GRM188R71E104KA01
C26, C27: 39p; C_0603_1608Metric_Pad1.08x0.95mm_HandSolder; MFG1 PN GRM1885C1H390JA01D
C29: 1u; C_0603_1608Metric_Pad1.08x0.95mm_HandSolder; MFG1 PN C2012X7R1E105K125AB
FB3, FB4: 220; L_0603_1608Metric; MFG1 PN BLM18AG221SN1
J1: XLR; PinHeader_1x03_P2.54mm_Vertical
J2, J4, J5, J6, J7: MONO JACK; PinHeader_1x02_P2.54mm_Vertical
K2: Fujitsu_FTR-LYCA005x; Relay_SPDT_Fujitsu_FTR-LYCA005x_FormC_Vertical
R5: 1M; R_0805_2012Metric
R12, R30, R31, R34, R36, R37: 100; R_0805_2012Metric; MPN CRCW0805100RFKEA
R13: 34; R_0805_2012Metric; MFG1 PN RC0805JR-0710RL
R32, R33: 47k; R_0805_2012Metric; MPN RC0805FR-0747KL
U5: CS4272; TSSOP-28_4.4x9.7mm_P0.65mm; MFG1 PN CS4272-CZZ
U9: OPA1655D; SOIC-8_3.9x4.9mm_P1.27mm; MPN OPA1655D
X1: 24.576 MHz 20 pF; Crystal_SMD_HC49-SD_HandSoldering; MFG1 PN ABM3-24.576MHZ-B2-T

Connections:
+3.3V: FB3.1; also elsewhere on the board
+5VA: C38.1, FB4.2, K2.A1, U9.7 (V+); also elsewhere on the board
/CodecAndAnalog/ADC_DATA: U5.6 (SDOUT); also elsewhere on the board
/CodecAndAnalog/BCLK: U5.5 (SCLK); also elsewhere on the board
/CodecAndAnalog/InputBufferA/OUT_N: U5.16 (AINA_N); also elsewhere on the board
/CodecAndAnalog/InputBufferA/OUT_P: U5.17 (AINA_P); also elsewhere on the board
/CodecAndAnalog/InputBufferA/VCOM: R13.1; also elsewhere on the board
/CodecAndAnalog/InputBufferA/VSIGIN: C21.1; also elsewhere on the board
/CodecAndAnalog/InputBufferB/OUT_N: U5.19 (AINB_N); also elsewhere on the board
/CodecAndAnalog/InputBufferB/OUT_P: U5.18 (AINB_P); also elsewhere on the board
/CodecAndAnalog/InputBufferB/VSIGIN: C23.1; also elsewhere on the board
/CodecAndAnalog/LRCLK: U5.4 (LRCLK); also elsewhere on the board
/CodecAndAnalog/MicPreamp/IN_N: J1.2; also elsewhere on the board
/CodecAndAnalog/MicPreamp/IN_P: J1.1; also elsewhere on the board
/CodecAndAnalog/MicPreamp/OUT: K2.12; also elsewhere on the board
/CodecAndAnalog/OutputBufferA/IN_N: U5.24 (AOUTA_N); also elsewhere on the board
/CodecAndAnalog/OutputBufferA/IN_P: U5.25 (AOUTA_P); also elsewhere on the board
/CodecAndAnalog/OutputBufferA/OUT: C34.1; also elsewhere on the board
/CodecAndAnalog/OutputBufferB/IN_N: U5.27 (AOUTB_N); also elsewhere on the board
/CodecAndAnalog/OutputBufferB/IN_P: U5.26 (AOUTB_P); also elsewhere on the board
/CodecAndAnalog/OutputBufferB/OUT: C56.1; also elsewhere on the board
/CodecAndAnalog/REL_CTRL: K2.A2, R36.2, R37.2
/CodecAndAnalog/SCLK: U5.3 (MCLK); also elsewhere on the board
/CodecAndAnalog/VCOM: C29.1, C31.1, U5.15 (VCOM), U9.3 (+)
/CodecAndAnalog/VD_FILT: C20.1, C25.1, FB3.2, U5.9 (VD), U5.10 (VL)
/TeensyAndDigital/C_DAC_DATA: U5.7 (SDIN); also elsewhere on the board
/TeensyAndDigital/C_RESET: U5.14 (RST_N); also elsewhere on the board
/TeensyAndDigital/C_SCL: U5.11 (SCL); also elsewhere on the board
/TeensyAndDigital/C_SDA: U5.12 (SDA); also elsewhere on the board
GND: C18.2, C20.2, C25.2, C26.1, C27.1, C28.2, C29.2, C30.2, C31.2, C32.2, C38.2, J2.2, J4.2, J5.2, J6.2, J7.1, R5.2, R32.1, R33.1, U5.8 (DGND), U5.13 (AD0), U5.21 (AGND), U9.4 (V-); also elsewhere on the board
GNDPWR: J1.3, R5.1; also elsewhere on the board
unnamed: C21.2, R12.2
unnamed: C23.2, R34.2
unnamed: C34.2, R31.1
unnamed: C56.2, R30.1
unnamed: J2.1, K2.14
unnamed: J4.1, R12.1
unnamed: J5.1, R30.2, R32.2
unnamed: J6.1, R31.2, R33.2
unnamed: J7.2, R36.1, R37.1
unnamed: K2.11, R34.1
unnamed: C18.1, C32.1, U5.22 (FILT)
unnamed: C28.1, C30.1, FB4.1, U5.20 (VA)
unnamed: C26.2, U5.2 (XTI), X1.1
unnamed: C27.2, U5.1 (XTO), X1.2
unnamed: R13.2, U9.2 (-), U9.6

Notes on the sheet:
Gang 2 resistors for power rating 100 mA
Output B
CS4272 datasheet only mentions one 0.1uF and one 1uF capacitor per power supply pin, but use one 0.1uF cap and one 10uF cap instead. This provides <1 ohm impedance across frequency as long as 10uF cap is close to power supply pin (<0.5")
Input B
(c) 2015 by RF William Hollender (whollender@gmail.com) Licensed under Creative Commons CC-BY-SA-NC v4.0 Not for commercial use
Analog I/O channel selection (L/R) determined by ATAPI bits in register at address 0x03
Line / Mic
Output A
Input A

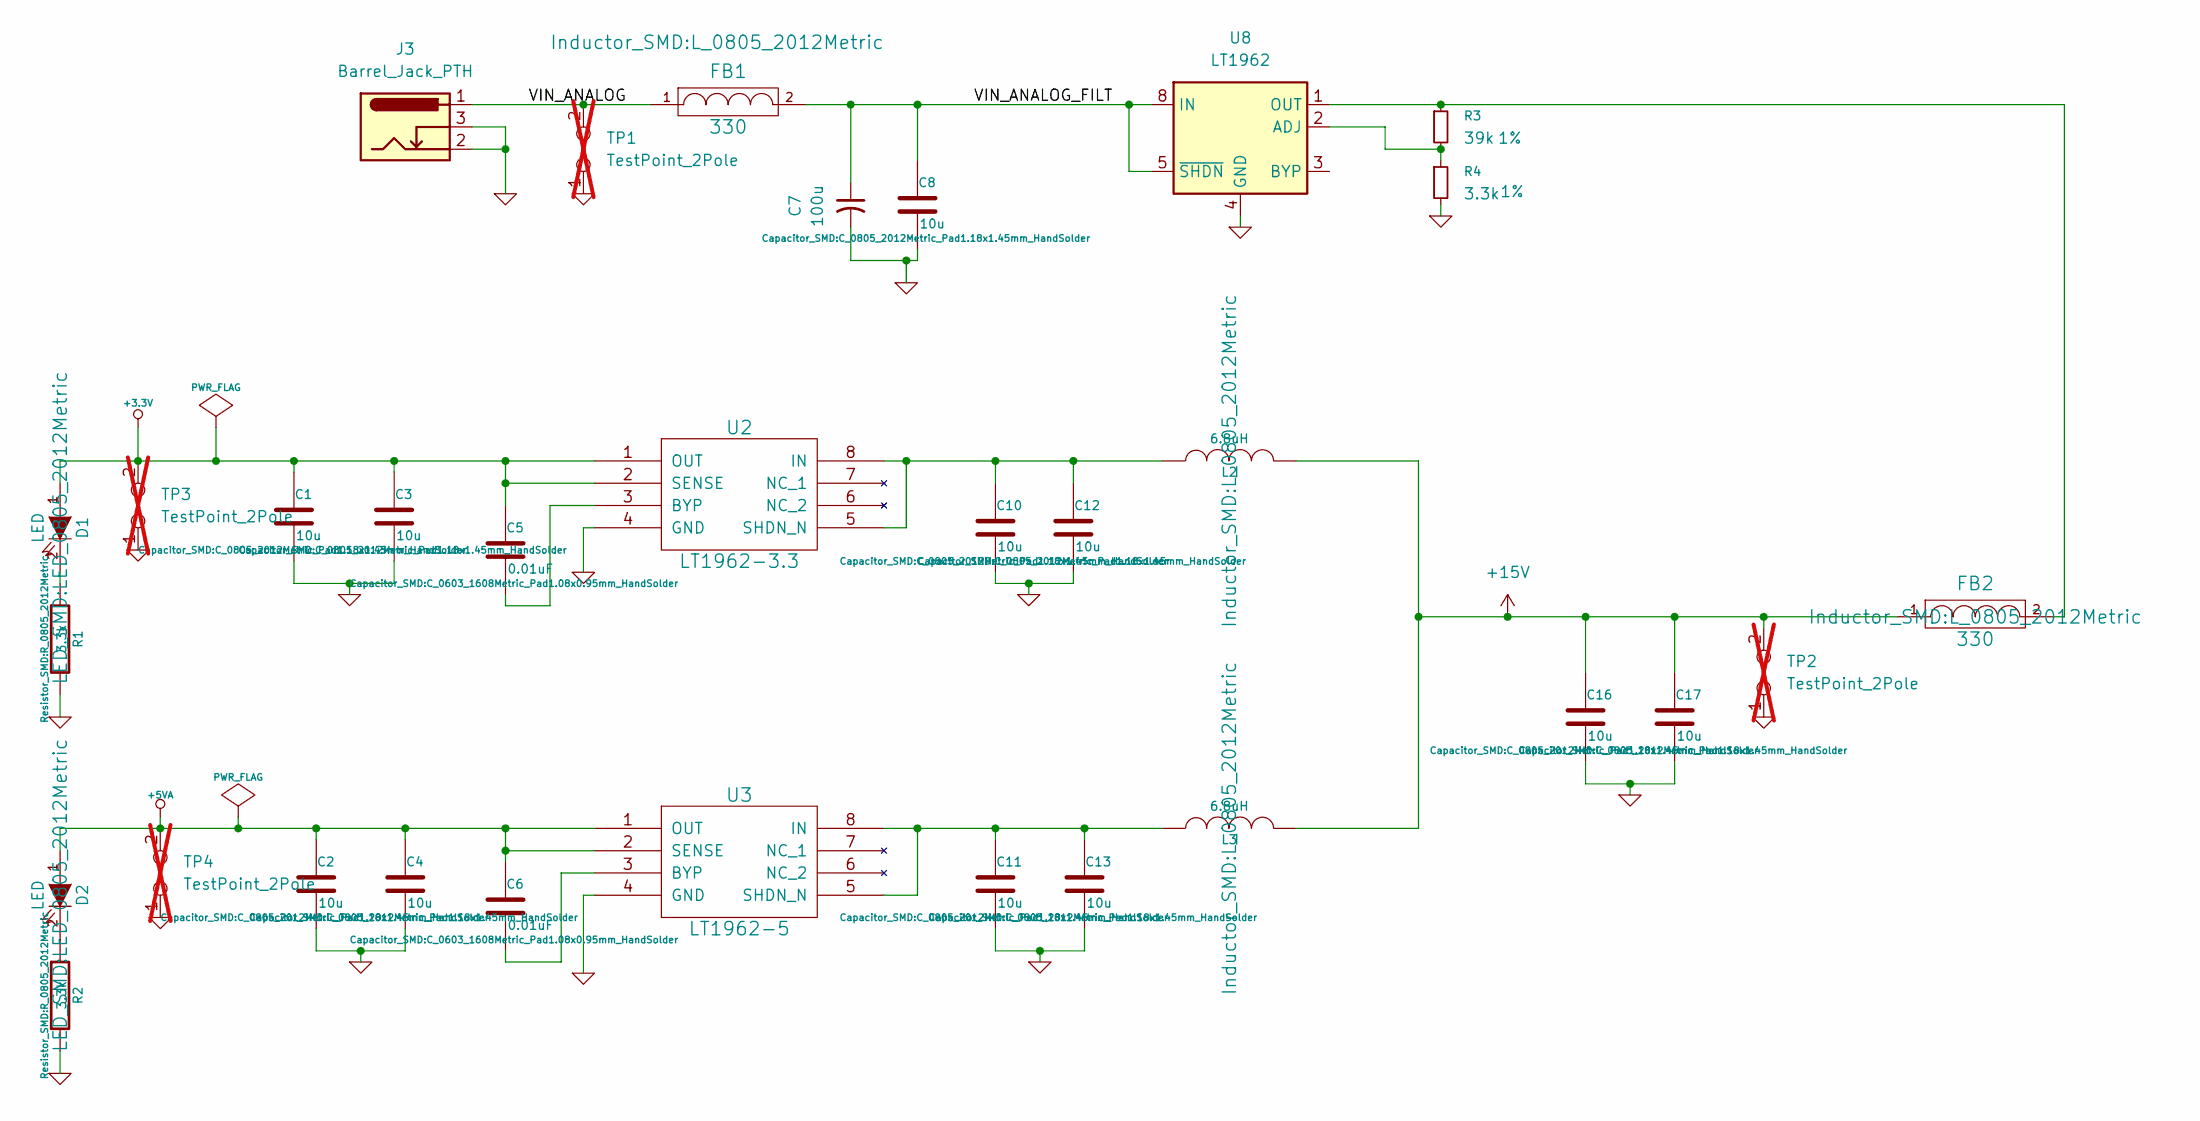
[picture p28: schematic PowerSupply.kicad_sch, 24 bit audio board for Teensy 3.x]

Parts:
C1, C2, C3, C4, C8, C10, C11, C12, C13, C16, C17: 10u; C_0805_2012Metric_Pad1.18x1.45mm_HandSolder; Voltage 25V; MFG1 PN GRM32DR71E106KA12
C5, C6: 0.01uF; C_0603_1608Metric_Pad1.08x0.95mm_HandSolder; MFG1 PN GRM2195C1H103JA01D
C7: 100u; CP_Radial_D5.0mm_P2.00mm; MPN 25PX100MEFC5X11
D1, D2: LED; LED_0805_2012Metric; MFG1 PN APT2012CGCK
FB1, FB2: 330; L_0805_2012Metric; MFG1 PN BLM21PG331SN1D
J3: Barrel_Jack_PTH
L2, L3: 6.8uH; L_0805_2012Metric; MFG1 PN MSS1038-522NLB
R1: 3.3k; R_0805_2012Metric; MFG1 PN ERJ-6GEYJ271V
R2: 3.3k; R_0805_2012Metric; MFG1 PN ERJ-6GEYJ621V
R3: 39k; R_0805_2012Metric; MPN ERA-6AEB3922V
R4: 3.3k; R_0805_2012Metric; MPN ERA-6AEB332V
TP1, TP2, TP3, TP4: TestPoint_2Pole; TestPoint_2Pads_Pitch2.54mm_Drill0.8mm; not fitted
U2: LT1962-3.3; MSOP-8_3x3mm_P0.65mm; MFG1 PN LT1962EMS8-3.3#PBF
U3: LT1962-5; MSOP-8_3x3mm_P0.65mm; MFG1 PN LT1962EMS8-5#PBF-ND
U8: LT1962; MSOP-8_3x3mm_P0.65mm; MPN LT1962EMS8

Connections:
+3.3V: C1.1, C3.1, C5.1, D1.1 (A), TP3.2, U2.1 (OUT), U2.2 (SENSE); also elsewhere on the board
+5VA: C2.1, C4.1, C6.1, D2.1 (A), TP4.2, U3.1 (OUT), U3.2 (SENSE); also elsewhere on the board
+15V: C16.1, C17.1, FB2.1, L2.2, L3.2, TP2.2; also elsewhere on the board
/PowerSupply/VIN_ANALOG: FB1.1, J3.1 (PWR), TP1.2
/PowerSupply/VIN_ANALOG_FILT: C7.1, C8.1, FB1.2, U8.5 (~SHDN), U8.8 (IN)
GND: C1.2, C2.2, C3.2, C4.2, C7.2, C8.2, C10.2, C11.2, C12.2, C13.2, C16.2, C17.2, J3.2 (GND), J3.3 (GNDBREAK), R1.2, R2.2, R4.2, TP1.1, TP2.1, TP3.1, TP4.1, U2.4 (GND), U3.4 (GND), U8.4 (GND); also elsewhere on the board
unnamed: D1.2 (K), R1.1
unnamed: D2.2 (K), R2.1
unnamed: C5.2, U2.3 (BYP)
unnamed: C10.1, C12.1, L2.1, U2.5 (SHDN_N), U2.8 (IN)
unnamed: C6.2, U3.3 (BYP)
unnamed: C11.1, C13.1, L3.1, U3.5 (SHDN_N), U3.8 (IN)
unnamed: R3.2, R4.1, U8.2 (ADJ)
unnamed: FB2.2, R3.1, U8.1 (OUT)

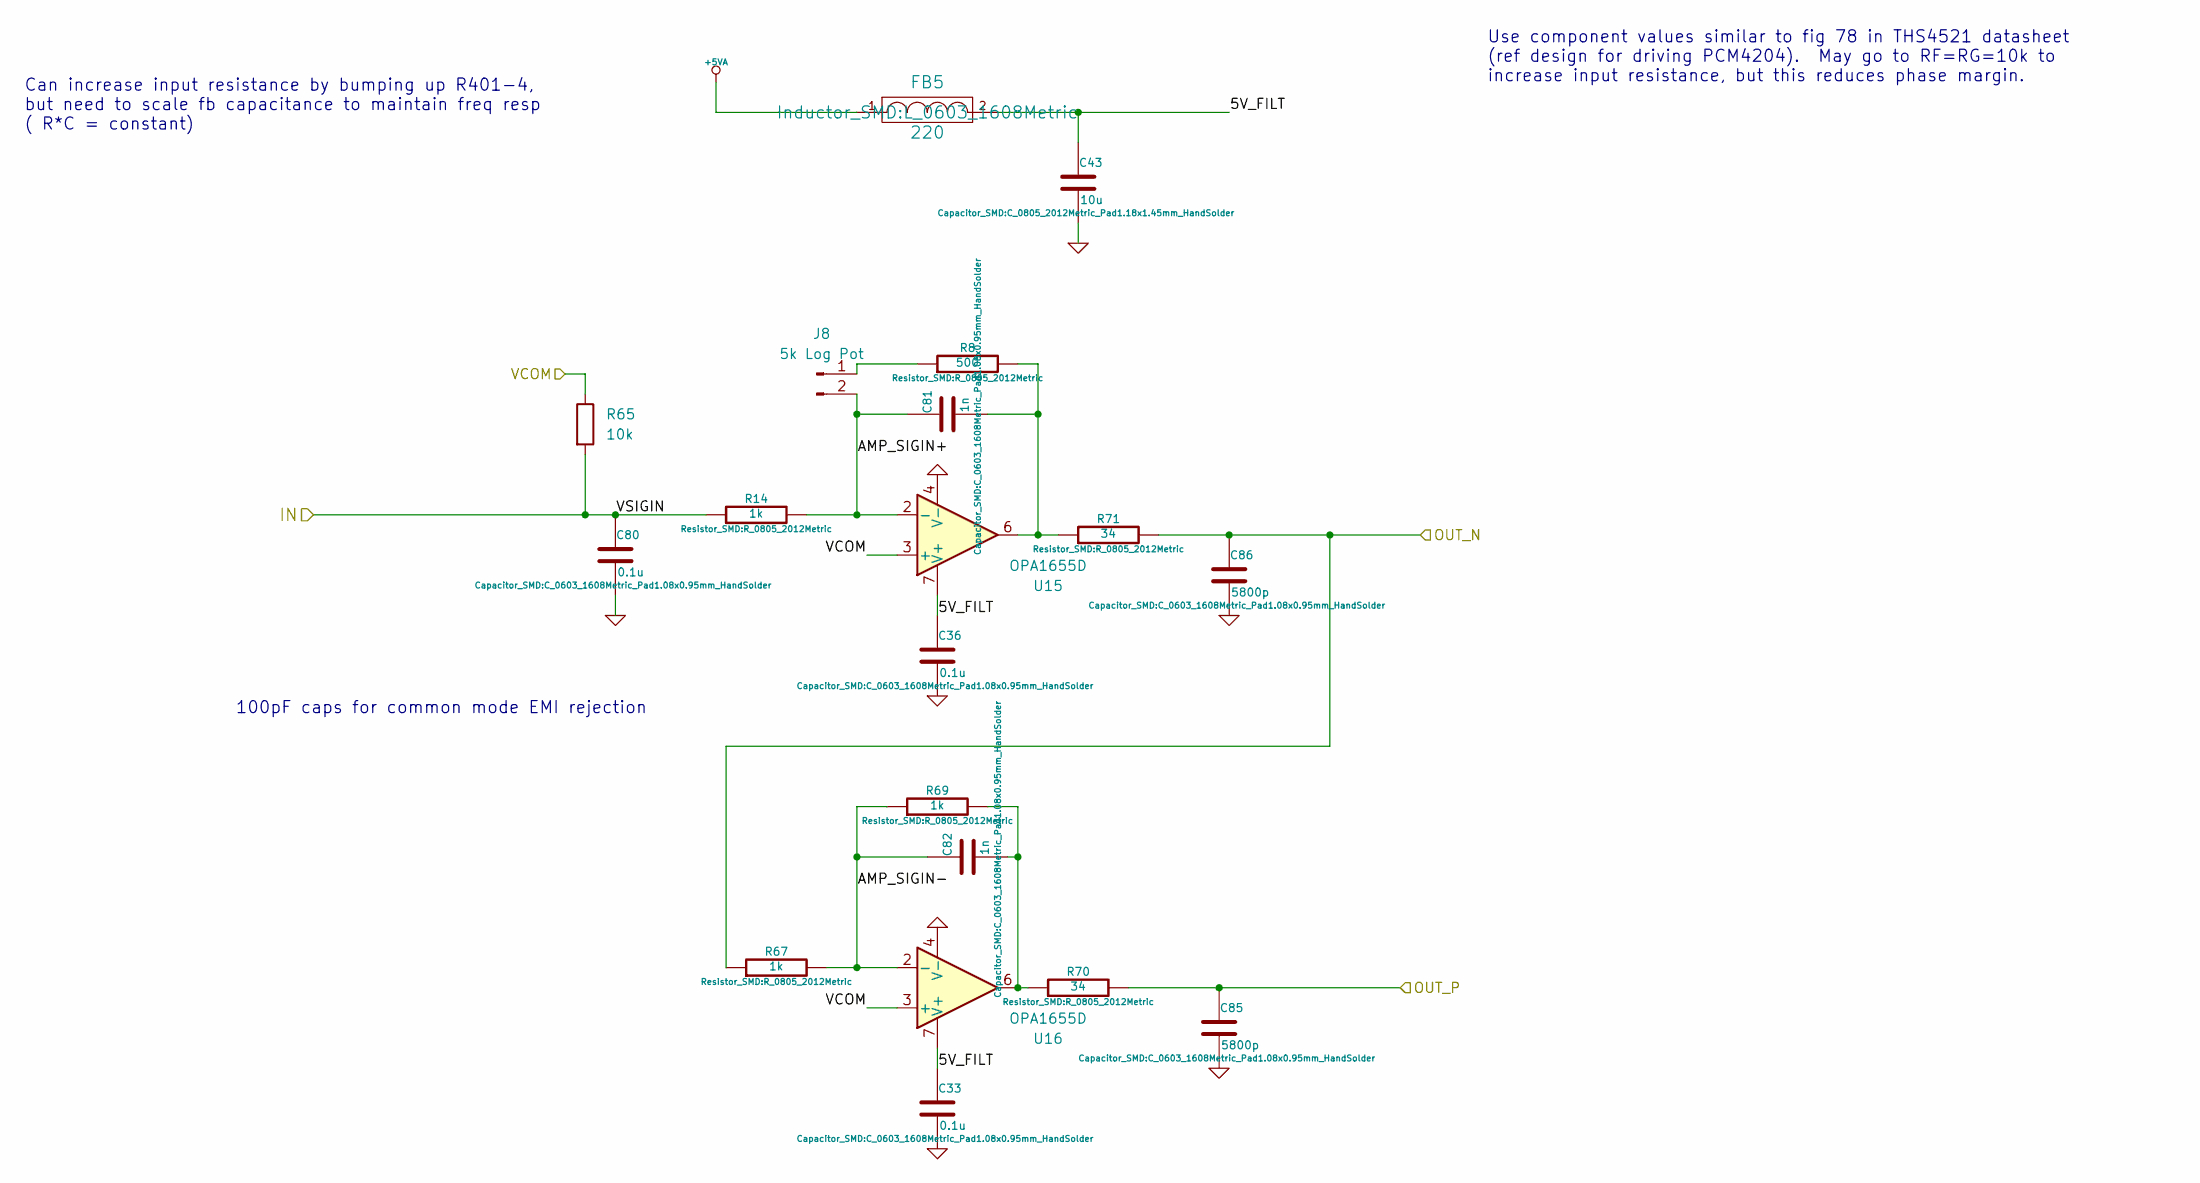
[picture p29: schematic AnalogInputBuffer.kicad_sch, 24 bit audio board for Teensy 3.x]

Parts:
C33, C36: 0.1u; C_0603_1608Metric_Pad1.08x0.95mm_HandSolder; MFG1 PN GRM188R71E104KA01
C43: 10u; C_0805_2012Metric_Pad1.18x1.45mm_HandSolder; Voltage 25V; MFG1 PN GRM32DR71E106KA12
C80: 0.1u; C_0603_1608Metric_Pad1.08x0.95mm_HandSolder; MFG1 PN GRM1885C1H101JA01D
C81, C82: 1n; C_0603_1608Metric_Pad1.08x0.95mm_HandSolder; MFG1 PN GRM2165C1H102FA01D
C85, C86: 5800p; C_0603_1608Metric_Pad1.08x0.95mm_HandSolder; MFG1 PN GRM2165C1H272JA01D
FB5: 220; L_0603_1608Metric; MFG1 PN BLM18AG221SN1
J8: 5k Log Pot; PinHeader_1x02_P2.54mm_Vertical; MPN RV16AF-10-15K-C5K-3LA
R8: 500; R_0805_2012Metric; MFG1 PN RG2012P-102-B-T5
R14, R67, R69: 1k; R_0805_2012Metric; MFG1 PN RG2012P-102-B-T5
R65: 10k; R_0805_2012Metric; MPN CRCW080510K0FKEA
R70, R71: 34; R_0805_2012Metric; MFG1 PN RR1220Q-40R2-D-M
U15, U16: OPA1655D; SOIC-8_3.9x4.9mm_P1.27mm; MPN OPA1655D

Connections:
+5VA: FB5.1; also elsewhere on the board
/CodecAndAnalog/InputBufferA/5V_FILT: C33.1, C36.1, C43.1, FB5.2, U15.7 (V+), U16.7 (V+)
/CodecAndAnalog/InputBufferA/AMP_SIGIN+: C81.1, J8.2, R14.2, U15.2 (-)
/CodecAndAnalog/InputBufferA/AMP_SIGIN-: C82.1, R67.2, R69.1, U16.2 (-)
/CodecAndAnalog/InputBufferA/OUT_N: C86.1, R67.1, R71.2; also elsewhere on the board
/CodecAndAnalog/InputBufferA/OUT_P: C85.1, R70.2; also elsewhere on the board
/CodecAndAnalog/InputBufferA/VCOM: R65.1, U15.3 (+), U16.3 (+); also elsewhere on the board
/CodecAndAnalog/InputBufferA/VSIGIN: C80.1, R14.1, R65.2; also elsewhere on the board
GND: C33.2, C36.2, C43.2, C80.2, C85.2, C86.2, U15.4 (V-), U16.4 (V-); also elsewhere on the board
unnamed: C81.2, R8.2, R71.1, U15.6
unnamed: C82.2, R69.2, R70.1, U16.6
unnamed: J8.1, R8.1

Parts of its further copies:
C35, C37: 0.1u; C_0603_1608Metric_Pad1.08x0.95mm_HandSolder; MFG1 PN GRM188R71E104KA01
C52: 10u; C_0805_2012Metric_Pad1.18x1.45mm_HandSolder; Voltage 25V; MFG1 PN GRM32DR71E106KA12
C90: 0.1u; C_0603_1608Metric_Pad1.08x0.95mm_HandSolder; MFG1 PN GRM1885C1H101JA01D
C91, C92: 1n; C_0603_1608Metric_Pad1.08x0.95mm_HandSolder; MFG1 PN GRM2165C1H102FA01D
C95, C96: 5800p; C_0603_1608Metric_Pad1.08x0.95mm_HandSolder; MFG1 PN GRM2165C1H272JA01D
FB6: 220; L_0603_1608Metric; MFG1 PN BLM18AG221SN1
J9: 5k Log Pot; PinHeader_1x02_P2.54mm_Vertical; MPN RV16AF-10-15K-C5K-3LA
R9: 500; R_0805_2012Metric; MFG1 PN RG2012P-102-B-T5
R15, R76, R78: 1k; R_0805_2012Metric; MFG1 PN RG2012P-102-B-T5
R74: 10k; R_0805_2012Metric; MPN CRCW080510K0FKEA
R79, R80: 34; R_0805_2012Metric; MFG1 PN RR1220Q-40R2-D-M
U17, U18: OPA1655D; SOIC-8_3.9x4.9mm_P1.27mm; MPN OPA1655D

Connections of its further copies:
+5VA: FB6.1; also elsewhere on the board
/CodecAndAnalog/InputBufferA/VCOM: R74.1, U17.3 (+), U18.3 (+); also elsewhere on the board
/CodecAndAnalog/InputBufferB/5V_FILT: C35.1, C37.1, C52.1, FB6.2, U17.7 (V+), U18.7 (V+)
/CodecAndAnalog/InputBufferB/AMP_SIGIN+: C91.1, J9.2, R15.2, U17.2 (-)
/CodecAndAnalog/InputBufferB/AMP_SIGIN-: C92.1, R76.2, R78.1, U18.2 (-)
/CodecAndAnalog/InputBufferB/OUT_N: C96.1, R76.1, R80.2; also elsewhere on the board
/CodecAndAnalog/InputBufferB/OUT_P: C95.1, R79.2; also elsewhere on the board
/CodecAndAnalog/InputBufferB/VSIGIN: C90.1, R15.1, R74.2; also elsewhere on the board
GND: C35.2, C37.2, C52.2, C90.2, C95.2, C96.2, U17.4 (V-), U18.4 (V-); also elsewhere on the board
unnamed: C91.2, R9.2, R80.1, U17.6
unnamed: C92.2, R78.2, R79.1, U18.6
unnamed: J9.1, R9.1

Notes on the sheet:
Use component values similar to fig 78 in THS4521 datasheet (ref design for driving PCM4204). May go to RF=RG=10k to increase input resistance, but this reduces phase margin.
100pF caps for common mode EMI rejection
Can increase input resistance by bumping up R401-4, but need to scale fb capacitance to maintain freq resp ( R*C = constant)
