sshersh/SuperAudioBoard/KiCADFiles/Board/SuperAudioBoard.kicad_pcb

## KiCad design KiCADFiles/Board/SuperAudioBoard.kicad_pcb (continued)

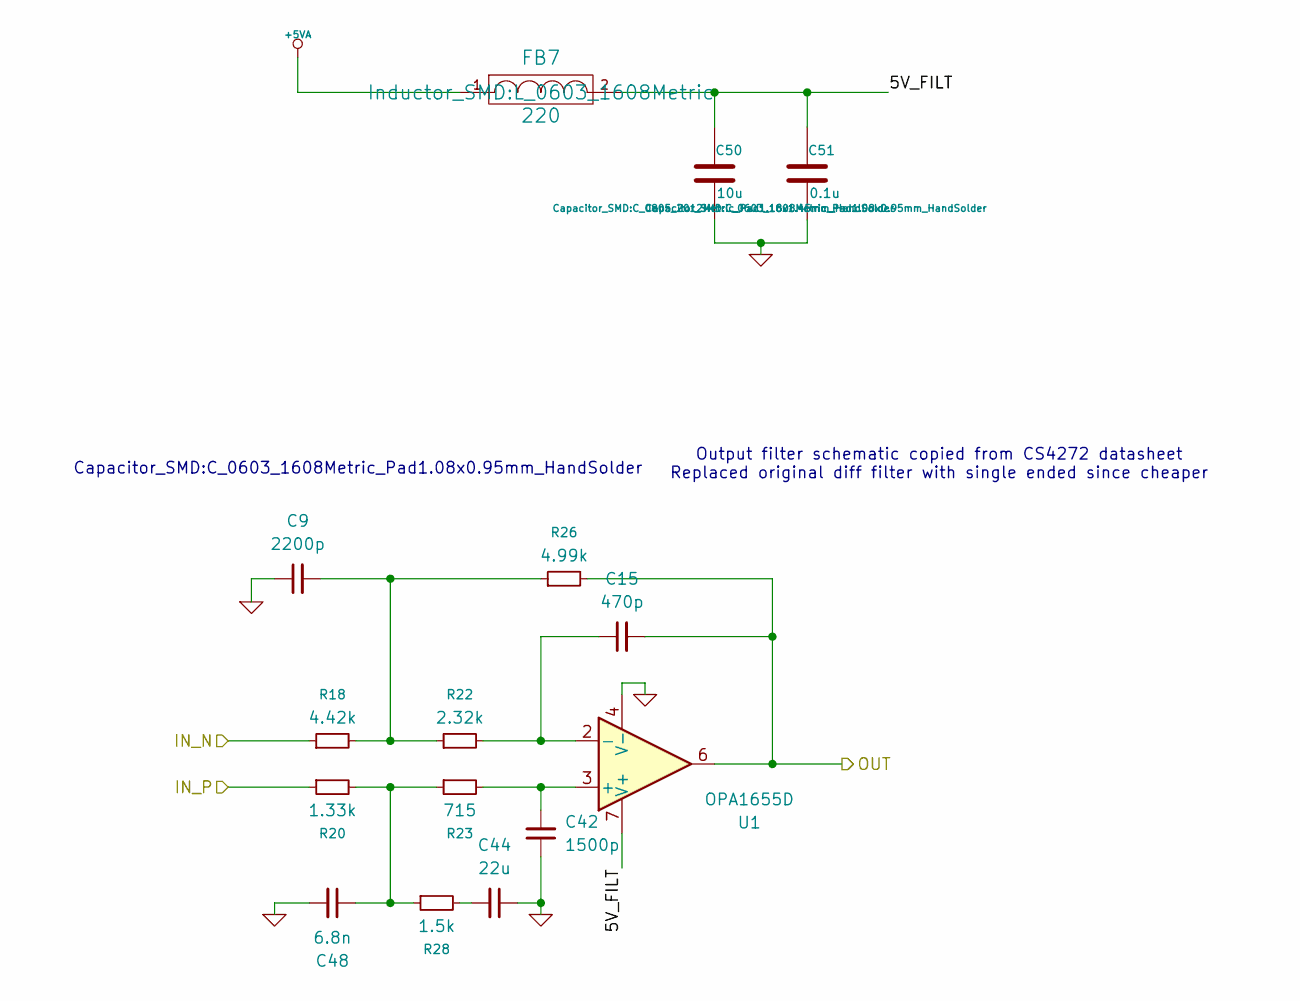
[picture p30: schematic AnalogOutputBuffer.kicad_sch, 24 bit audio board for Teensy 3.x]

Parts:
C9: 2200p; C_0603_1608Metric_Pad1.08x0.95mm_HandSolder; MPN GRM1885C1H222JA01D
C15: 470p; C_0603_1608Metric_Pad1.08x0.95mm_HandSolder; MPN 08053C471KAT2A
C42: 1500p; C_0603_1608Metric_Pad1.08x0.95mm_HandSolder; MPN C0603C152F1GACTU
C44: 22u; C_0805_2012Metric_Pad1.18x1.45mm_HandSolder; MPN KAM21AT70J226MU
C48: 6.8n; C_0603_1608Metric_Pad1.08x0.95mm_HandSolder; MPN GRM1885C1H682JA01D
C50: 10u; C_0805_2012Metric_Pad1.18x1.45mm_HandSolder; Voltage 25V; MFG1 PN GRM32DR71E106KA12
C51: 0.1u; C_0603_1608Metric_Pad1.08x0.95mm_HandSolder; MFG1 PN GRM188R71E104KA01
FB7: 220; L_0603_1608Metric; MFG1 PN BLM18AG221SN1
R18: 4.42k; R_0805_2012Metric; MPN ERA-6AEB4421V
R20: 1.33k; R_0805_2012Metric; MPN ERA-6AEB1331V
R22: 2.32k; R_0805_2012Metric; MPN RMCF0805FT2K32
R23: 715; R_0805_2012Metric; MPN RC0805FR-07715RL
R26: 4.99k; R_0805_2012Metric; MPN RG2012P-4991-B-T5
R28: 1.5k; R_0805_2012Metric; MPN RC0805FR-071K5L
U1: OPA1655D; SOIC-8_3.9x4.9mm_P1.27mm; MPN OPA1655D

Connections:
+5VA: FB7.1; also elsewhere on the board
/CodecAndAnalog/OutputBufferB/5V_FILT: C50.1, C51.1, FB7.2, U1.7 (V+)
/CodecAndAnalog/OutputBufferB/IN_N: R18.1; also elsewhere on the board
/CodecAndAnalog/OutputBufferB/IN_P: R20.1; also elsewhere on the board
/CodecAndAnalog/OutputBufferB/OUT: C15.2, R26.2, U1.6; also elsewhere on the board
GND: C9.1, C42.1, C44.1, C48.2, C50.2, C51.2, U1.4 (V-); also elsewhere on the board
unnamed: C9.2, R18.2, R22.1, R26.1
unnamed: C44.2, R28.2
unnamed: C48.1, R20.2, R23.1, R28.1
unnamed: C42.2, R23.2, U1.3 (+)
unnamed: C15.1, R22.2, U1.2 (-)

Parts of its further copies:
C14: 2200p; C_0603_1608Metric_Pad1.08x0.95mm_HandSolder; MPN GRM1885C1H222JA01D
C41: 470p; C_0603_1608Metric_Pad1.08x0.95mm_HandSolder; MPN 08053C471KAT2A
C45: 1500p; C_0603_1608Metric_Pad1.08x0.95mm_HandSolder; MPN C0603C152F1GACTU
C46: 22u; C_0805_2012Metric_Pad1.18x1.45mm_HandSolder; MPN KAM21AT70J226MU
C49: 6.8n; C_0603_1608Metric_Pad1.08x0.95mm_HandSolder; MPN GRM1885C1H682JA01D
C54: 10u; C_0805_2012Metric_Pad1.18x1.45mm_HandSolder; Voltage 25V; MFG1 PN GRM32DR71E106KA12
C55: 0.1u; C_0603_1608Metric_Pad1.08x0.95mm_HandSolder; MFG1 PN GRM188R71E104KA01
FB8: 220; L_0603_1608Metric; MFG1 PN BLM18AG221SN1
R19: 4.42k; R_0805_2012Metric; MPN ERA-6AEB4421V
R21: 1.33k; R_0805_2012Metric; MPN ERA-6AEB1331V
R24: 2.32k; R_0805_2012Metric; MPN RMCF0805FT2K32
R25: 715; R_0805_2012Metric; MPN RC0805FR-07715RL
R27: 4.99k; R_0805_2012Metric; MPN RG2012P-4991-B-T5
R29: 1.5k; R_0805_2012Metric; MPN RC0805FR-071K5L
U4: OPA1655D; SOIC-8_3.9x4.9mm_P1.27mm; MPN OPA1655D

Connections of its further copies:
+5VA: FB8.1; also elsewhere on the board
/CodecAndAnalog/OutputBufferA/5V_FILT: C54.1, C55.1, FB8.2, U4.7 (V+)
/CodecAndAnalog/OutputBufferA/IN_N: R19.1; also elsewhere on the board
/CodecAndAnalog/OutputBufferA/IN_P: R21.1; also elsewhere on the board
/CodecAndAnalog/OutputBufferA/OUT: C41.2, R27.2, U4.6; also elsewhere on the board
GND: C14.1, C45.1, C46.1, C49.2, C54.2, C55.2, U4.4 (V-); also elsewhere on the board
unnamed: C14.2, R19.2, R24.1, R27.1
unnamed: C46.2, R29.2
unnamed: C49.1, R21.2, R25.1, R29.1
unnamed: C45.2, R25.2, U4.3 (+)
unnamed: C41.1, R24.2, U4.2 (-)

Notes on the sheet:
Capacitor_SMD:C_0603_1608Metric_Pad1.08x0.95mm_HandSolder
Output filter schematic copied from CS4272 datasheet Replaced original diff filter with single ended since cheaper

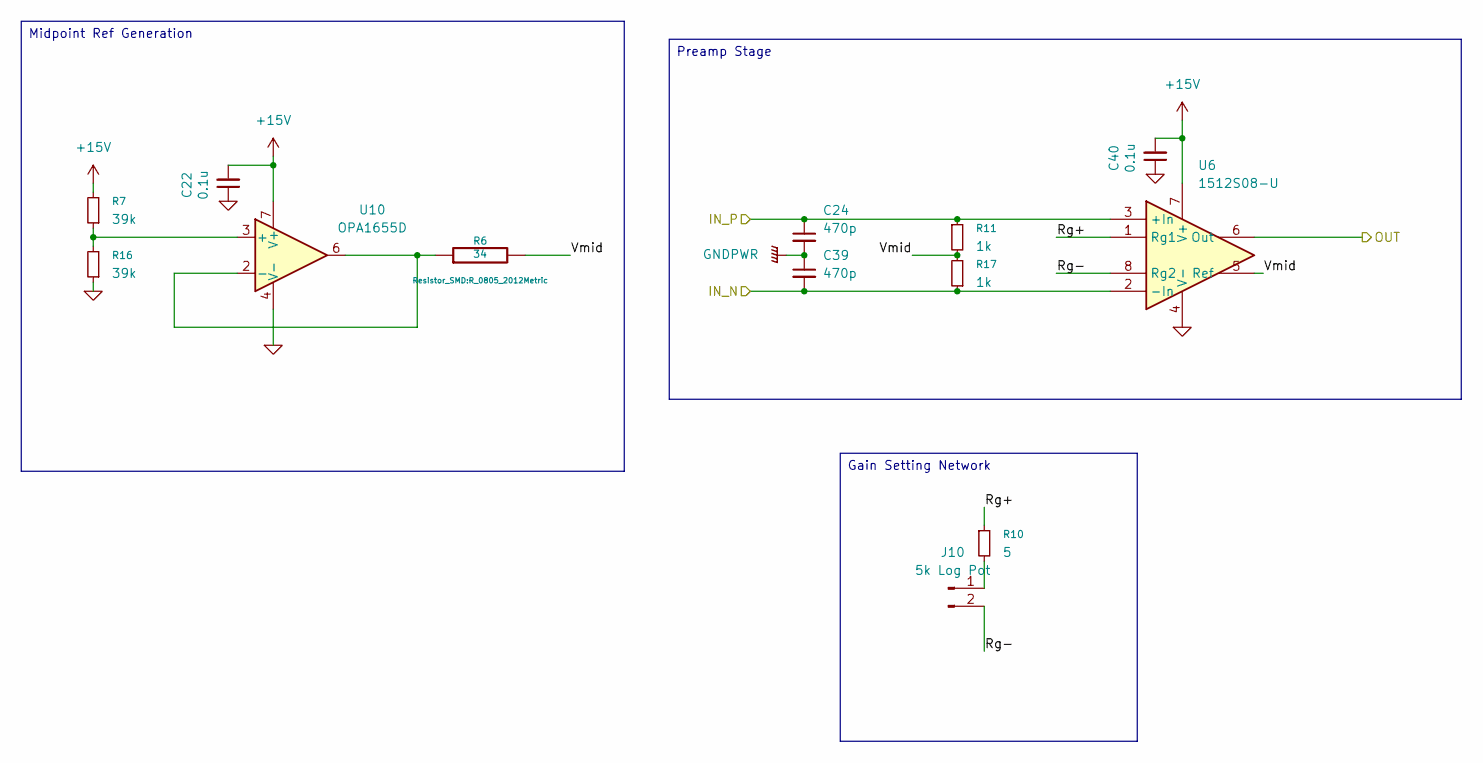
[picture p31: schematic MicPreamp.kicad_sch]

Parts:
C22, C40: 0.1u; C_0603_1608Metric_Pad1.08x0.95mm_HandSolder; Voltage 25V; Tolerance 20%; MPN CL10B104KB8NNNL
C24, C39: 470p; C_0603_1608Metric_Pad1.08x0.95mm_HandSolder; Voltage 50V; Tolerance 5%; MPN 08053C471KAT2A
J10: 5k Log Pot; PinHeader_1x02_P2.54mm_Vertical; MPN RV16AF-10-15K-C5K-3LA
R6: 34; R_0805_2012Metric; MFG1 PN RC0805JR-0710RL
R7, R16: 39k; R_0805_2012Metric; MPN ERA-6AEB3922V
R10: 5; R_0805_2012Metric; MPN RC0805FR-074R7L
R11, R17: 1k; R_0805_2012Metric; MPN ERA-6AEB102V
U6: 1512S08-U; SOIC-8_5.3x5.3mm_P1.27mm; MPN 1512S08-U
U10: OPA1655D; SOIC-8_3.9x4.9mm_P1.27mm; MPN OPA1655D

Connections:
+15V: C22.2, C40.2, R7.2, U6.7 (V+), U10.7 (V+); also elsewhere on the board
/CodecAndAnalog/MicPreamp/IN_N: C39.2, R17.1, U6.2 (-In); also elsewhere on the board
/CodecAndAnalog/MicPreamp/IN_P: C24.1, R11.1, U6.3 (+In); also elsewhere on the board
/CodecAndAnalog/MicPreamp/OUT: U6.6 (Out); also elsewhere on the board
/CodecAndAnalog/MicPreamp/Rg+: R10.1, U6.1 (Rg1)
/CodecAndAnalog/MicPreamp/Rg-: J10.2, U6.8 (Rg2)
/CodecAndAnalog/MicPreamp/Vmid: R6.2, R11.2, R17.2, U6.5 (Ref)
GND: C22.1, C40.1, R16.1, U6.4 (V-), U10.4 (V-); also elsewhere on the board
GNDPWR: C24.2, C39.1; also elsewhere on the board
unnamed: J10.1, R10.2
unnamed: R7.1, R16.2, U10.3 (+)
unnamed: R6.1, U10.2 (-), U10.6

Notes on the sheet:
Gain Setting Network
Preamp Stage
Midpoint Ref Generation

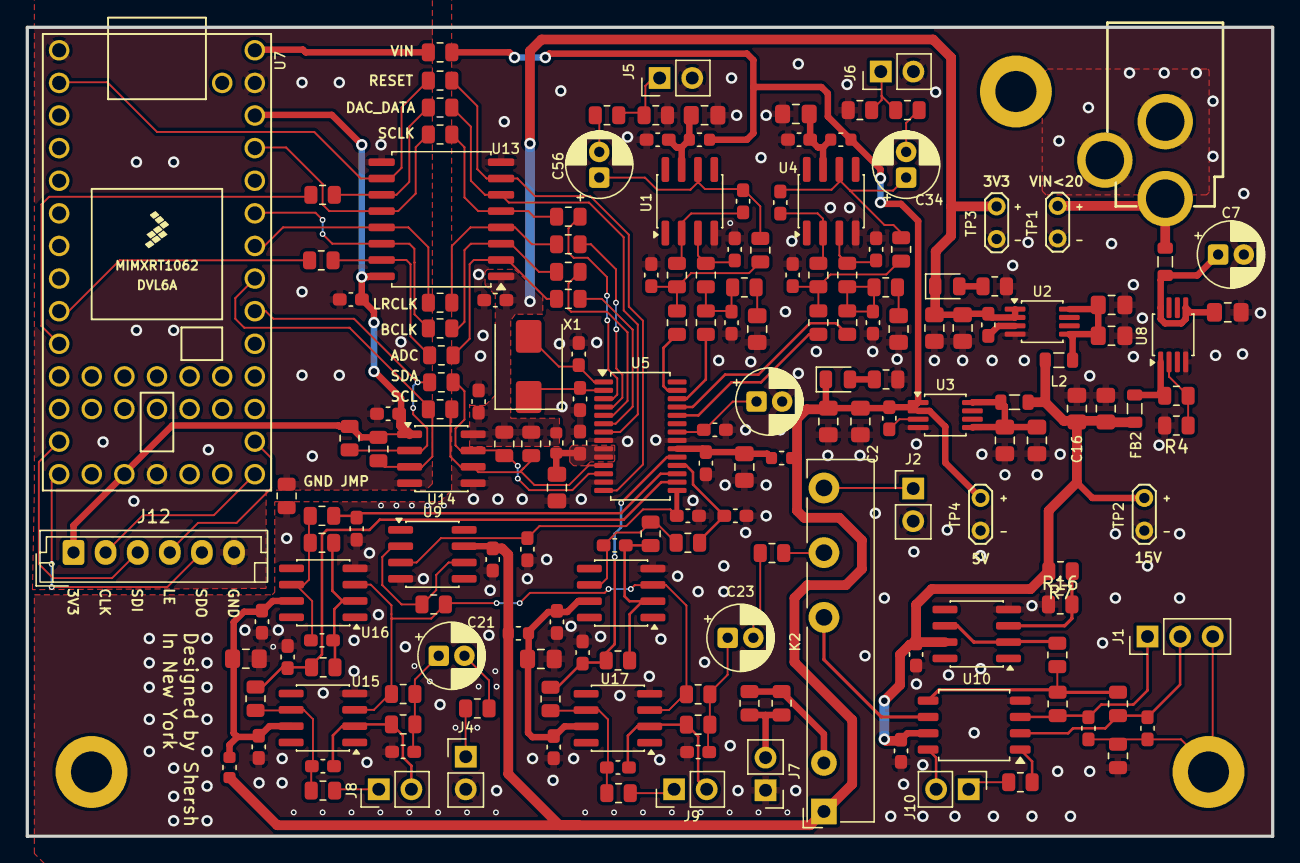
[picture p32: board SuperAudioBoard.kicad_pcb from above]

Board: 2 copper layers, 97.0 x 63.0 mm, 181 parts (0 on the bottom side), 108 nets.
