sshersh/SuperAudioBoard/(commit log)

2026-02-02 initial schematic with RPI pico
    [AnalogInputBuffer-2026-01-04-12-43-07.sch, AnalogInputBuffer-2026-01-04-12-46-50.sch, AnalogInputBuffer-2026-01-05-21-45-14.sch, AnalogInputBuffer.kicad_sch, AnalogOutputBuffer-2026-01-04-12-43-07.sch, AnalogOutputBuffer-2026-01-04-12-46-50.sch, AnalogOutputBuffer-2026-01-05-21-45-14.sch, AnalogOutputBuffer.kicad_sch]
2026-02-22 chose all components
    [AnalogInputBuffer.kicad_sch, AnalogOutputBuffer.kicad_sch, CodecAndAnalog.kicad_sch, MicPreamp.kicad_sch, PowerSupply.kicad_sch, SuperAudioBoard.kicad_pcb, TeensyAndDigital.kicad_sch]
2026-02-24 replaced sw with relay, routed line amp section
    [AnalogInputBuffer.kicad_sch, AnalogOutputBuffer.kicad_sch, CodecAndAnalog.kicad_sch, MicPreamp.kicad_sch, PowerSupply.kicad_sch, SuperAudioBoard.kicad_pcb]
2026-02-25 removed connectors and condensed layout
    [AnalogInputBuffer.kicad_sch, CodecAndAnalog.kicad_sch, Sim_Project.kicad_sch, SuperAudioBoard.kicad_pcb]
2026-02-27 improved layout further
    [AnalogInputBuffer.kicad_sch, AnalogOutputBuffer.kicad_sch, CodecAndAnalog.kicad_sch, MicPreamp.kicad_sch, SuperAudioBoard.kicad_pcb]
2026-02-28 made crystal footprint smaller
    [CodecAndAnalog.kicad_sch, SuperAudioBoard.kicad_pcb]
2026-03-02 placed all components, routed most
    [SuperAudioBoard.kicad_pcb]
2026-03-08 finished layout, passed DRC
    [AnalogInputBuffer.kicad_sch, AnalogOutputBuffer.kicad_sch, CodecAndAnalog.kicad_sch, MicPreamp.kicad_sch, PowerSupply.kicad_sch, SuperAudioBoard.kicad_pcb, SuperAudioBoard.kicad_sch, TeensyAndDigital.kicad_sch]
2026-03-09 improved layout for noise immunity
    [SuperAudioBoard.kicad_pcb]
2026-03-12 added LED driver JST connector
    [SuperAudioBoard-B_Cu.gbl, SuperAudioBoard-B_Mask.gbs, SuperAudioBoard-B_SilkS.gbo, SuperAudioBoard-Dwgs_User.gbr, SuperAudioBoard-Edge_Cuts.gbr, SuperAudioBoard-F_Cu.gtl, SuperAudioBoard-F_Mask.gts, SuperAudioBoard-F_SilkS.gto]
